GeeArDee/MScThesis/Thesis/main.tex

\special{pdf:minorversion 7}
\let\pdfcreationdate=\creationdate
\PassOptionsToPackage{dvipsnames}{xcolor}
\documentclass[12pt,letterpaper,twoside]{report}
%\usepackage{colorprofiles}
%\usepackage[a-2b,mathxmp]{pdfx}
\usepackage[todonotes={textsize=scriptsize}, final]{changes}
\usepackage[left=1in, right=1in, top=1in, bottom=1in]{geometry}
\usepackage{setspace}
\usepackage{layout}
\usepackage{parskip}
\usepackage{amsmath}
\usepackage{amssymb}
\usepackage[T1]{fontenc}
\usepackage{fontspec}
\setmainfont{XCharter}
\usepackage{unicode-math}
\setmathfont{XCharter-Math.otf}
\setsansfont{IBMPlexSans}[
    Extension = .otf,
    UprightFont = *-Regular,
    BoldFont = *-SemiBold,
    ItalicFont = *-Italic,
    BoldItalicFont = *-SemiBoldItalic,
    Scale = MatchLowercase
]
\setmonofont{IBMPlexMono}[Scale=MatchLowercase]
\usepackage{multicol}
\usepackage{multirow}
\usepackage{pdfpages}
\usepackage{pdflscape}
\usepackage{afterpage}
\usepackage{graphicx}
% \DeclareGraphicsExtensions{.png,.pdf}
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
    pdftitle={Design and Validation of a Laser Thermal Propulsion Thruster Powered by a Fiber Laser},
    pdfauthor={Gabriel Roland Dubé},
    pdflang={en-CA},
    pdfsubject={For ambitious space missions like rapid human transit to Mars, conventional propulsion methods fall short. Laser-Thermal Propulsion (LTP) utilizes lasers to heat propellant gas, generating thrust with potentially greater specific impulse than traditional rocket engines. Two lab-scale LTP thrusters were tested in this thesis, denoted Version 1 (V1) and Version 2 (V2). Version 1 permitted initial testing and visualization of the Laser-Sustained Plasma (LSP) wave propagation. As a prototype for an actual thruster, Version 2 was optimized for thrust measurements. The design process of the improved V2 thruster is also presented. These thrusters were powered by a 300 W Continuous Wave (CW), 3 kW Quasi-Continuous Wave (QCW) 1.07 μm fiber laser. Argon was used as the propellant at a pressure of 20 bar, selected for its ease of ionization. Using an automotive-type coil, spark initiation of QCW LSP was successfully implemented in V1 and V2. Seeding of the argon with nitrogen dioxide (NO₂) at partial pressures between 0.12 bar to 0.55 bar showed the gas absorbed more than double the laser energy compared to pure argon propellant. To increase laser flux to the plasma, an optical system of two lenses was designed. Different lenses were compared using ray tracing software (WinLens3D). A CW LSP was achieved in V2, lasting 85.1 ms. This represents a 1.7 times longer lifetime than the maximum QCW pulse length of 50.0 ms at this power. Average cold flow thrust of V2 was approximately 1 N. In order to interpret the experimental results, a zero-dimensional (0D) heat transfer model was written in Python, using Bremsstrahlung as the mechanism of radiation. Finally, paths to further improve the V2 thruster and thrust stand are presented to eventually enable accurate thrust measurements with CW operation.},
    pdfkeywords={Laser thermal propulsion, Directed energy, Advanced propulsion, Interplanetary spaceflight, Space technologies},
    pdfstartview=
}
\setdeletedmarkup{\textcolor{McGillRed}{\sout{#1}}}
% \setdeletedmarkup{\textcolor{McGillRed}{#1}}
\definechangesauthor[color=violet, name={Emmanuel Duplay}]{ED}
\definechangesauthor[color=cyan, name={Barry Zandbergen}]{BZ}
\definechangesauthor[color=McGillRed, name={Andrew Higgins}]{AH}

\setlength{\marginparwidth}{2cm}

% \input{titlesec.tex}
\addbibresource{ref.bib}

\title{Laser-Powered Rocket Engine: small-scale experimental investigation}
\author{Gabriel Dubé}
\date{0000-00-00}

\renewcommand{\headrulewidth}{0pt}
\renewcommand{\chaptermark}[1]{\markboth{\MakeUppercase{\thechapter.\ #1}}{}}
\renewcommand{\sectionmark}[1]{\markright{\MakeUppercase{\thesection.\ #1}}}

\renewcommand{\chapterautorefname}{Chapter}
\renewcommand{\sectionautorefname}{Section}

\renewcommand\labelitemi{---}

\newcommand{\shotsettings}[4]{\texttt{#1}: #2~ms, \textit{f}/#3, ND#4}

\newcommand{\dd}[2]{\frac{\mathrm{d}#1}{\mathrm{d}#2}}
\newcommand{\ddi}[2]{\mathrm{d}#1/\mathrm{d}#2}

\newcommand{\blankpage}{%
    \null
    \thispagestyle{empty}%
    \addtocounter{page}{-1}%
    \newpage}

% Track changes commands
% \newcommand{\change}[1]{\textcolor{McGillRed}{#1}}
% \newenvironment{changeblock}{\color{McGillRed}}{}
% \renewcommand{\change}[1]{#1}  % Comment out to suppress changes
% \renewenvironment{changeblock}{}{}  % Comment out to suppress changes

\fancypagestyle{fancy}{
    \fancyhf{}
    \fancyhfinit{\sffamily}
    \lhead{\leftmark}
    \rhead{\rightmark}
    % \lfoot{AE5050}
    % \rfoot{\thepage}
    \fancyfoot[LE,RO]{\thepage}
    %\fancyfoot[RE,LO]{AE5050}
}

\fancypagestyle{plain}{
    \fancyhf{}
    \fancyfoot[C]{\sffamily \thepage}
    
}

\pagestyle{fancy}

\SetWatermarkText{\sffamily \textbf{DRAFT}}
\SetWatermarkFontSize{2cm}
\SetWatermarkColor[gray]{0.85}
    
\input{lstStyle.tex}
\input{customenvs.tex}

\sisetup{detect-all}

\begin{document}
    \setlength{\parindent}{0pt}
    \setlength{\headheight}{27.4pt}
    % \includepdf{assets/cover.pdf}
    \input{title page.tex}

    \pagenumbering{roman}

    \hypersetup{linkcolor=black}
    \tableofcontents
    
    \listoffigures
    \addcontentsline{toc}{chapter}{List of Figures}
    
    \listoftables
    \addcontentsline{toc}{chapter}{List of Tables}
    \hypersetup{linkcolor=cyan}
    
    \input{chapters/0_1_nomenclature.tex}

    % ------------  UNCOMMENT THESE!!!! ------------------

    \newpage
    \input{chapters/0_2_abstract.tex}
    \input{chapters/0_3_abstract_fr.tex}
    \input{chapters/0_0_preface.tex}
    \afterpage{\blankpage}
    \newpage
    \pagenumbering{arabic}

    % \input{chapters/unnumberedchapter.tex}

    %UNCOMMENT THESE!!!!
    
    \input{chapters/1_intro.tex}
    \input{chapters/3_design.tex}
    \input{chapters/4_experiments.tex}
    \input{chapters/2_models.tex}
    \input{chapters/5_discussion.tex}
    \input{chapters/6_conclusion.tex}
    
    \clearpage
    \defbibnote{bibmark}{\markright{}}
    \printbibliography[
        heading=bibintoc,
        title={References},
        block=ragged,
        prenote=bibmark
        ]
    \newpage

    \appendix
    \newcommand{\footeronly}{\thispagestyle{fancy}\markboth{}{}}
    \chapter{YLR-300/3000-QCW-MM-AC Calibration Report}
        \label{chp:app_YLR}
        \includepdf[pages=-, pagecommand={\footeronly}]{assets/appendices/IPGLaser300-3000_calib.pdf}
    \chapter{P30 Collimator Calibration Report}
        \label{chp:app_Collimator}
        \includepdf[pages=-, pagecommand={\footeronly}]{assets/appendices/D30_Collimator_calib.pdf}
    \chapter{Omega PX119A-1KG5V Calibration}
        \label{chp:omega calibration}
        \includepdf[pages=-, pagecommand={\footeronly}]{assets/appendices/Omega Calibration.pdf}
    \chapter{V2 Test Section Parts Drawings}
        \label{chp:V2 Test Section Drawings}
        \includepdf[pages=-, pagecommand={\footeronly}]{assets/appendices/Test Apparatus.pdf}
    \chapter{V2 Second (Rear) Window Mount}
        \label{chp:V2 rear window mount}
        \includepdf[pages=-, pagecommand={\footeronly}]{assets/appendices/New V2 parts/Second Window Mount Final.pdf}
    \chapter{Untested V2 Parts Drawings}
        \includepdf[pages=-, pagecommand={\footeronly}]{assets/appendices/New V2 parts/sriel2_Extension cylinder real.pdf}\label{chp:Extension cylinder}
        \includepdf[pages=-, pagecommand={\footeronly}]{assets/appendices/New V2 parts/Inner Cylinder.pdf}\label{chp:remachined inner cylinder}
        \includepdf[pages=-, pagecommand={\footeronly}]{assets/appendices/New V2 parts/Exchangeable Nozzle.pdf}\label{chp:New nozzle}
        \includepdf[pages=-, pagecommand={\footeronly}]{assets/appendices/New V2 parts/sriel2_Exchangeable Nozzle Plate_inches.pdf}\label{chp:Exchangeable nozzle plate}
        \includepdf[pages=-, pagecommand={\footeronly}]{assets/appendices/New V2 parts/Higher Width Plate.pdf}\label{chp:thicker plate}

    % List of appendicies that I want:
        % [x] Laser and colimator calibration
        % [x] Bubble meter calibration Thariq's report
        % [x] Drawings for V2 from Capstone team
        % [x] V2 rear window mount
        % Drawings of untested parts
            % [x] Modified inner cylinder
            % [x] Spacer for static tests
            % [x] Flat plate with hole for bubble tests
            % [x] Flat plate for changeable graphite nozzles
            % [x] Graphite nozzles
    
\end{document}
