GeeArDee/MScThesis/Thesis/title page.tex

\begin{titlepage}
  \thispagestyle{empty}
  \sffamily
  \begin{center}
     \\
    \vspace*{2cm}
    
    \huge
    \textbf{Design and Validation of a Laser~Thermal~Propulsion~Thruster Powered~by~a~Fiber~Laser}
    
    \large
    % \textit{Small-scale experimental investigation}     

    \vspace{1.5cm}    
    \textbf{Gabriel Roland Dubé}\\

    \vspace{0.5cm}
    Department of Mechanical Engineering\\
    McGill University, Montreal\\

    \vspace{1.5cm}
    July 2025\\
    \vspace{1.5cm}
    
    A thesis submitted to McGill University \\
    in partial fulfillment of the requirements of the degree of\\
    \textbf{Master of Science}\\
    
    %\vskip 10mm
    \vfill

    {\color{red}\hrule}

    \copyright Gabriel Roland Dubé, 2025
            
  \end{center}
\end{titlepage}
