GeeArDee/MScThesis/Emmanuel's Thesis/assets/cover.pdf

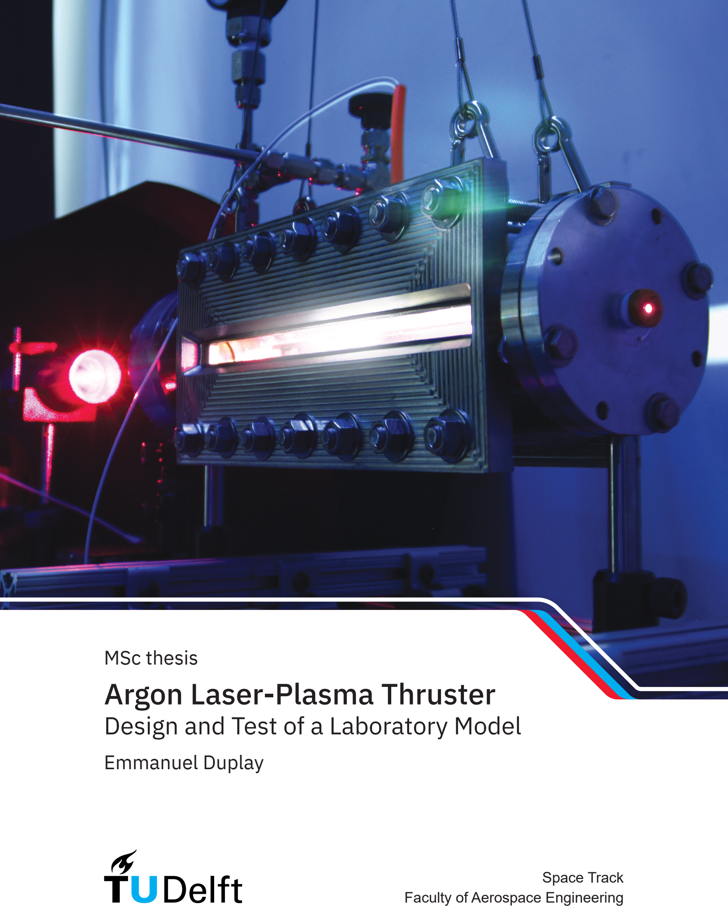
[picture p34: page 1]

## MSc thesis

# Argon Laser-Plasma Thruster

# Design and Test of a Laboratory Model

## Emmanuel Duplay

Space Track
Faculty of Aerospace Engineering
