GeeArDee/MScThesis/Thesis/assets/2 models/Mechanism of LSP growth.pdf

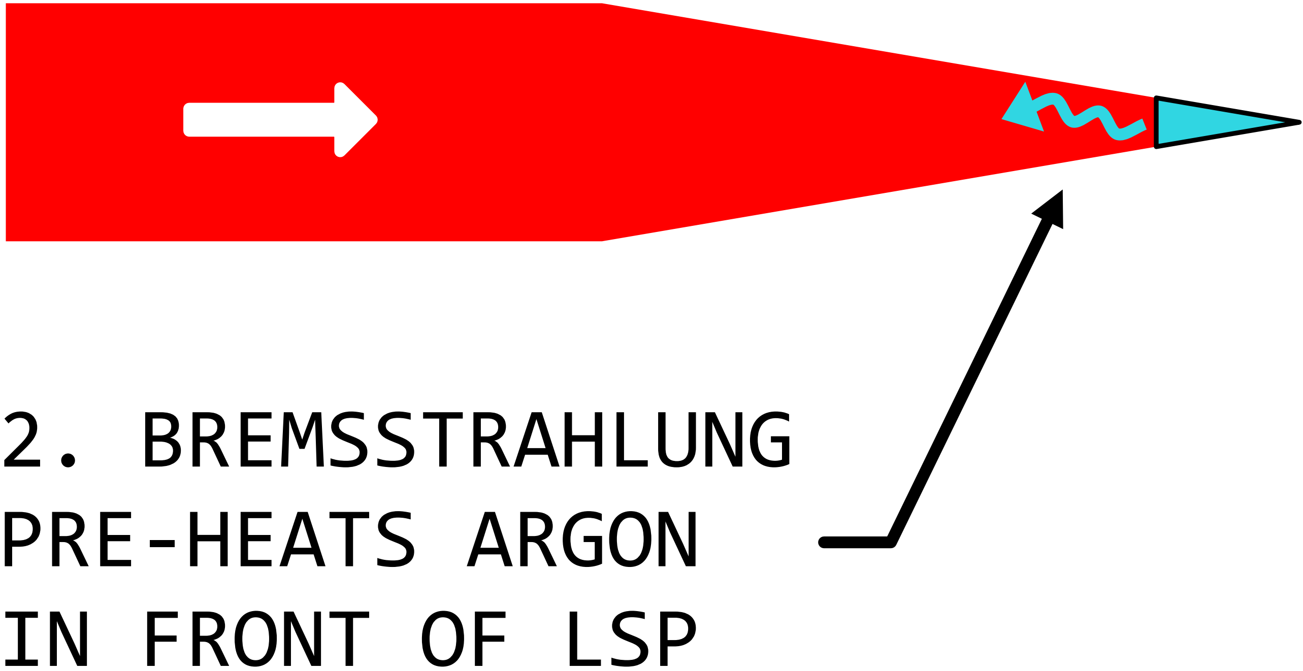
[picture p35: figure]
2. BREMSSTRAHLUNG PRE-HEATS ARGON IN FRONT OF LSP

3. LSP GROWTH
UPSTREAM
1. LASER ENERGY IN
