GeeArDee/MScThesis/Thesis/assets/2 models/Modeling figure.pdf

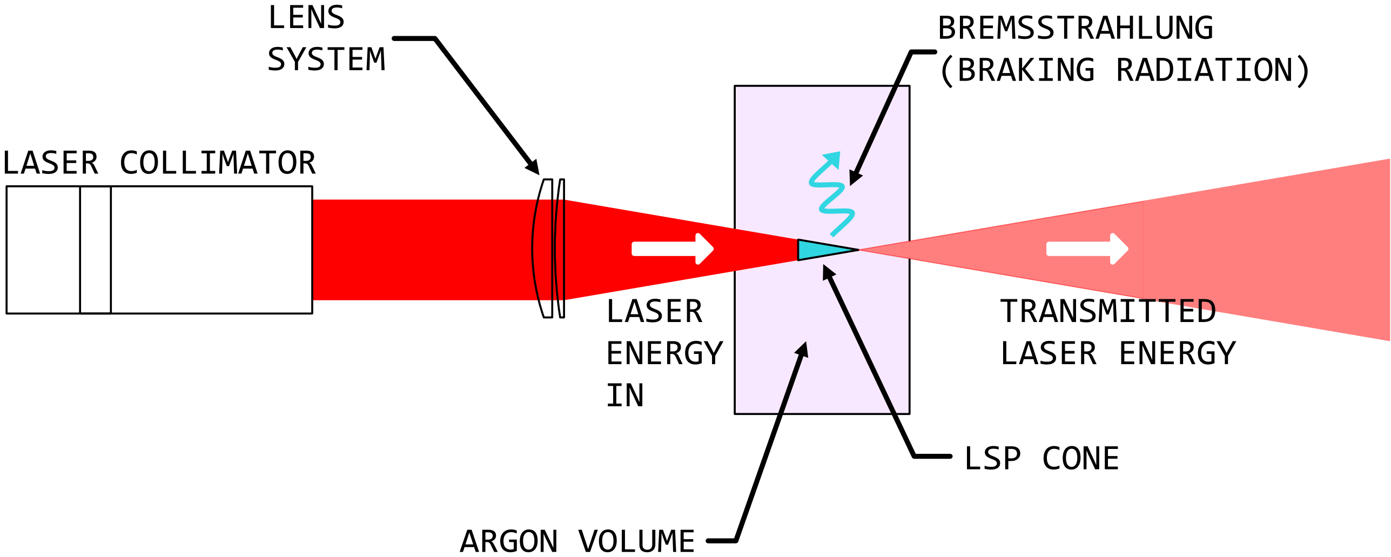
[picture p36: figure]
LASER COLLIMATOR; LENS SYSTEM; LSP CONE; ARGON VOLUME; TRANSMITTED LASER ENERGY; LASER ENERGY IN; BREMSSTRAHLUNG (BRAKING RADIATION)
