GeeArDee/MScThesis/Thesis/assets/3 design/100 lens spot size.pdf

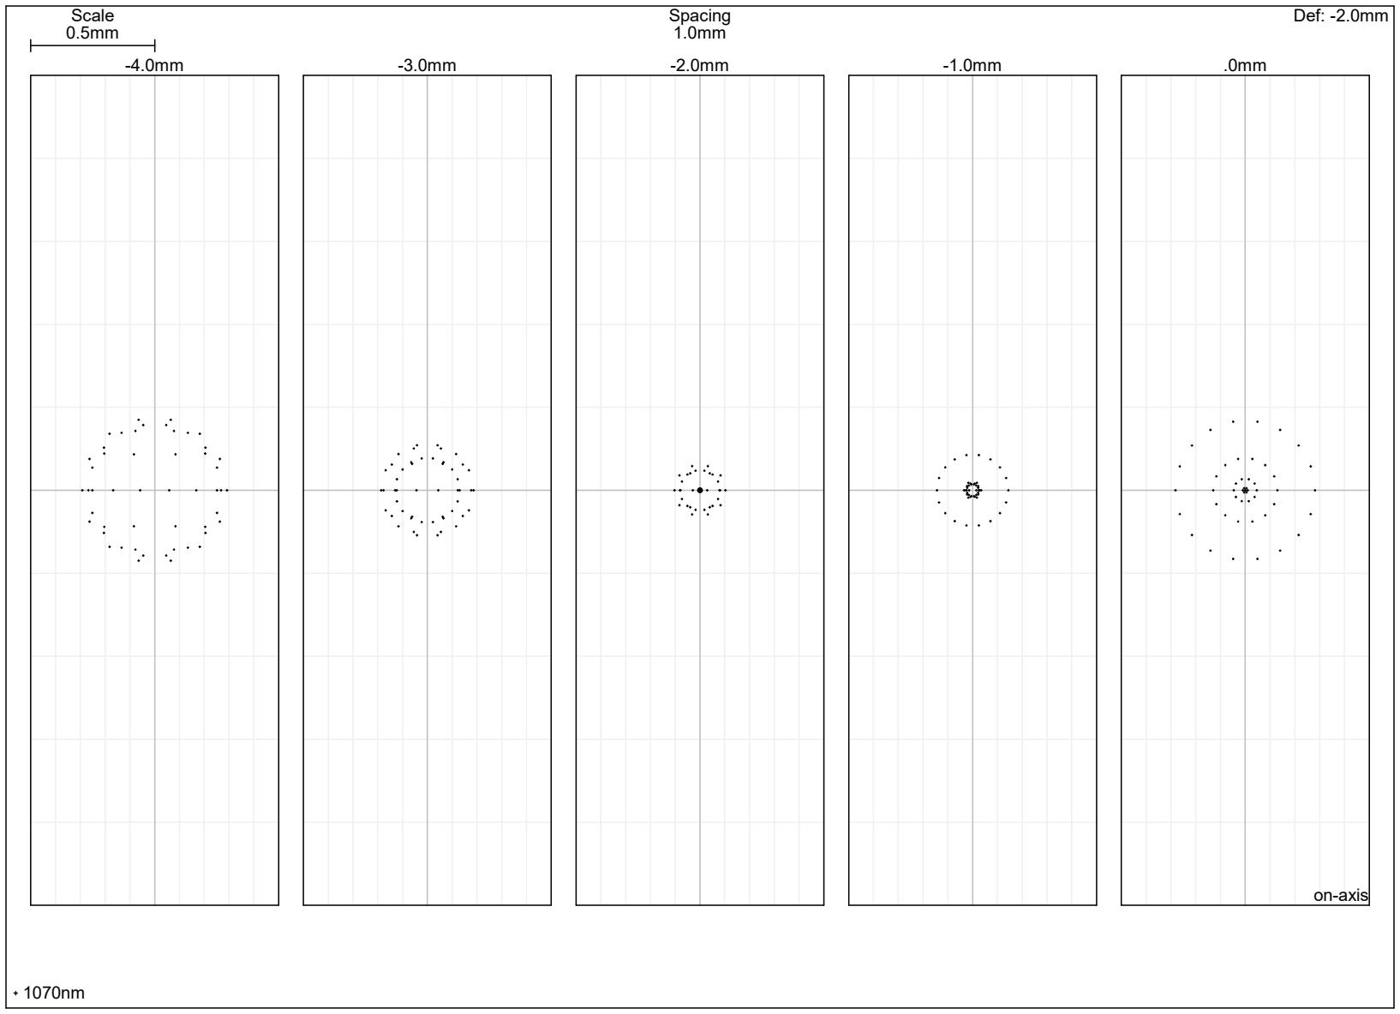
[picture p39: figure]
Scale 0.5mm; Spacing 1.0mm; Def: -2.0mm; on-axis
