GeeArDee/MScThesis/Thesis/assets/3 design/500 and 150 lenses spot size.pdf

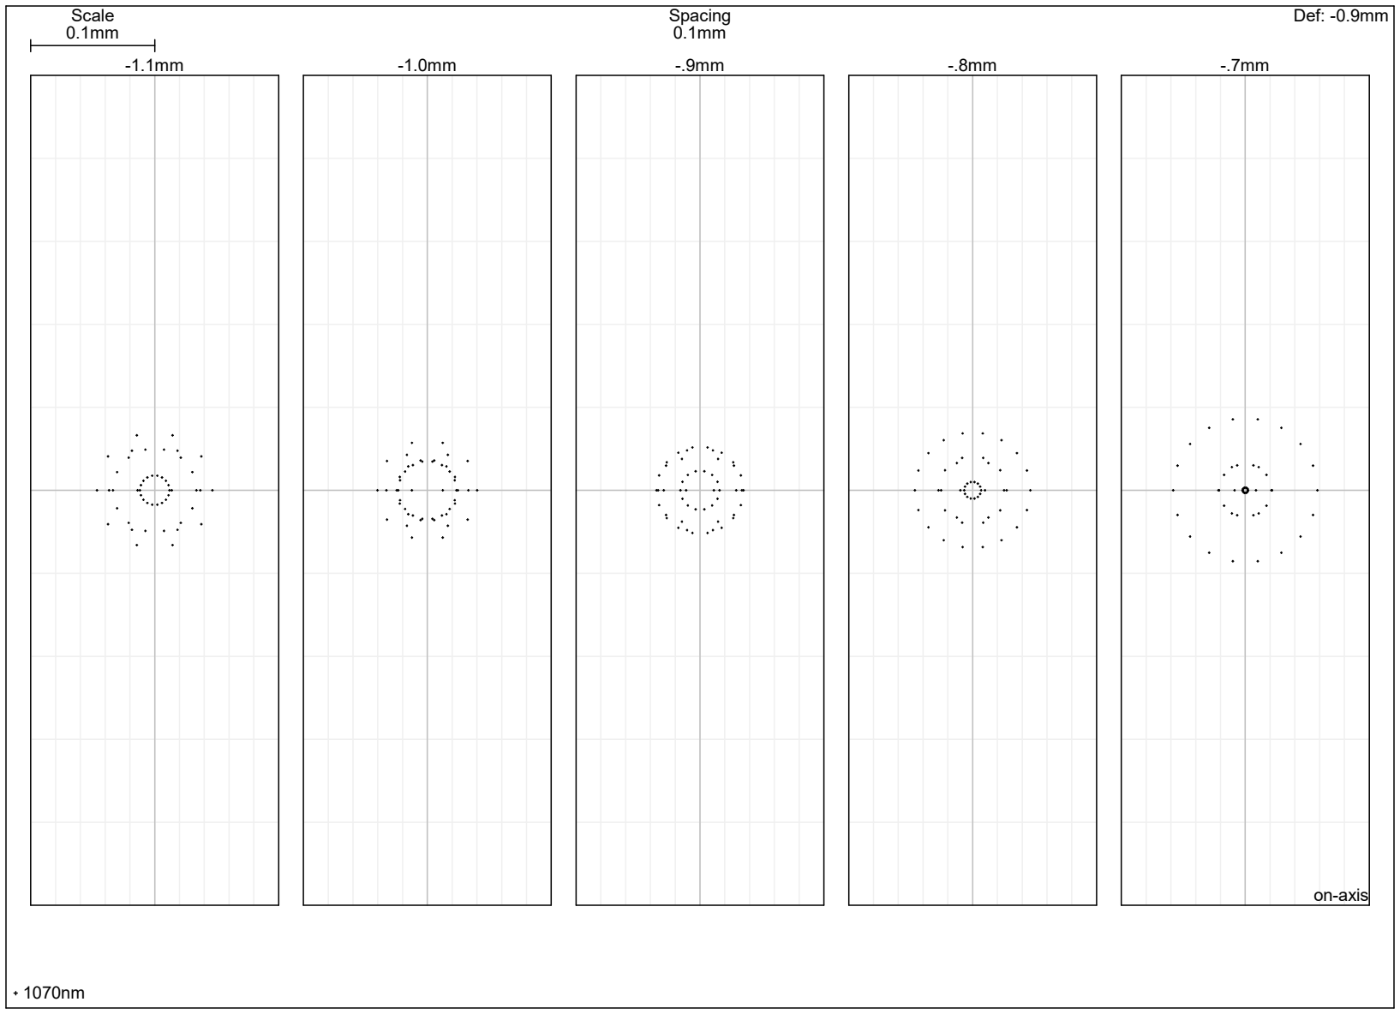
[picture p40: figure]
Scale 0.1mm; Spacing 0.1mm; Def: -0.9mm; on-axis
