GeeArDee/MScThesis/Thesis/assets/2 background/Kamei apparatus.png

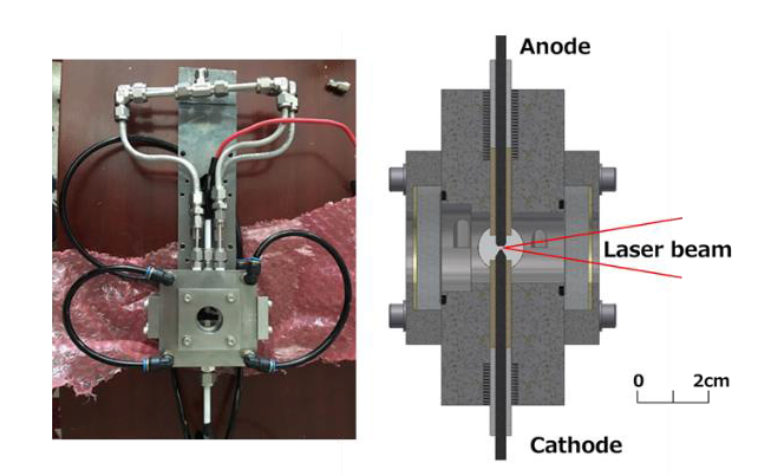
Thesis/assets/2 background/Kamei apparatus.png
