GeeArDee/MScThesis/Thesis/assets/2 background/Shoji_assy.png

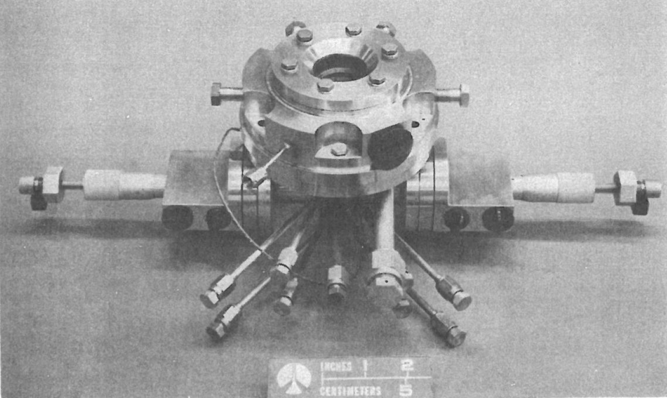
Thesis/assets/2 background/Shoji_assy.png
