GeeArDee/MScThesis/Thesis/assets/2 models/Brems vs exp graph.png

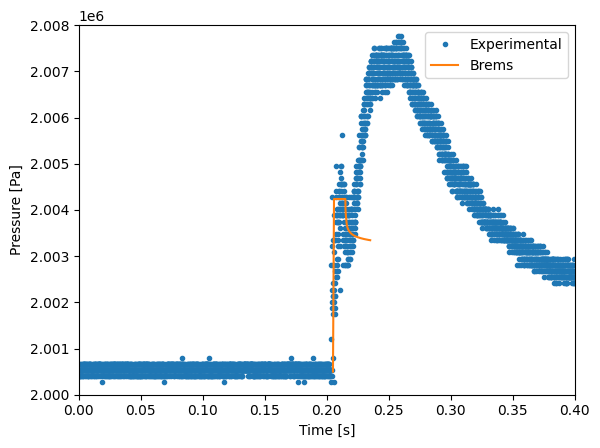
Thesis/assets/2 models/Brems vs exp graph.png
