GeeArDee/MScThesis/Thesis/assets/3 design/V1 IRL.jpg

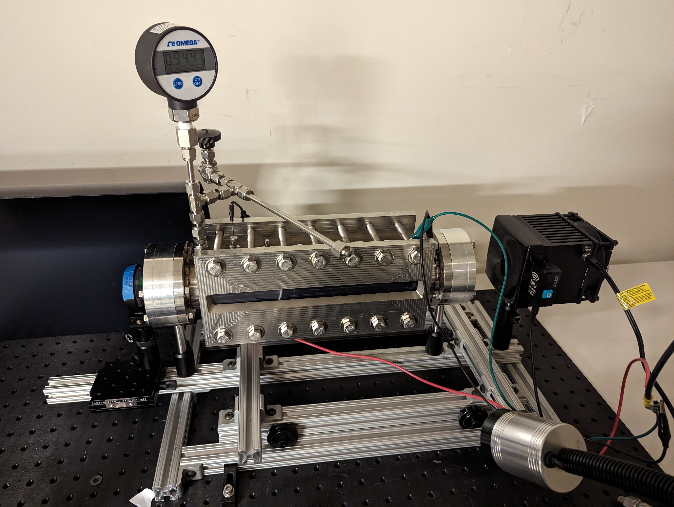
Thesis/assets/3 design/V1 IRL.jpg
