GeeArDee/MScThesis/Thesis/assets/5 discussion/hysterisis.png

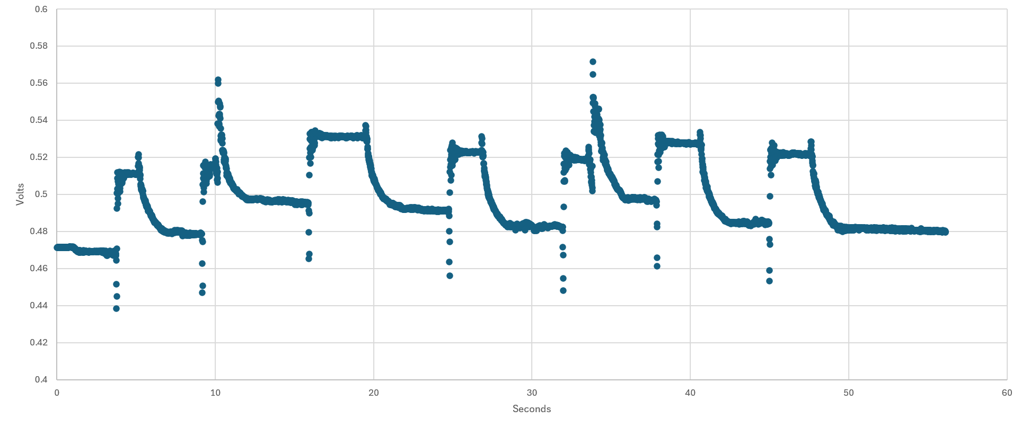
Thesis/assets/5 discussion/hysterisis.png
