GeeArDee/MScThesis/Thesis/chapters/0_1_nomenclature.tex

\chapter*{Nomenclature}
\setlength{\columnsep}{1cm}
\newenvironment{nomtable}
    {
        \centering
        \tabularx{\columnwidth}{r>{\raggedright\arraybackslash}X}
    }
    {
        \endtabularx
    }
\newenvironment{nomlist}
    {
        \begin{itemize}[leftmargin=1.5cm]
            \raggedright
            \setlength{\parsep}{0pt}
            \setlength{\itemsep}{-4pt}
    }
    {
        \end{itemize}
    }
\addcontentsline{toc}{chapter}{Nomenclature}
\markboth{\MakeUppercase{Nomenclature}}{}

% \newcommand{\evalc}{\qty{2.99792e8}{m.s^{-1}}}
% \newcommand{\evale}{\qty{1.60218e-19}{C}}
% \newcommand{\evalg}{\qty{9.80665}{m.s^{-2}}}
% \newcommand{\evalhbar}{\qty{1.05457e-34}{J.s}}
% \newcommand{\evalkB}{\qty{1.38065e-23}{J.K^{-1}}}
% \newcommand{\evalme}{\qty{9.10938e-31}{kg}}
% \newcommand{\evalNA}{\qty{6.02214e+23}{mol^{-1}}}
% \newcommand{\evalRu}{\qty{8.31446}{J.K^{-1}.mol^{-1}}}
% \newcommand{\evalepsilon}{\qty{8.85419e-12}{F.m^{-1}}}

% \section*{Physical Constants}
%     {\centering\sisetup{table-alignment-mode=format, table-number-alignment=right}
%         \begin{tabularx}{\textwidth}{@{}lXS[table-format = 1.5e4]@{ }lr@{}}
%             \toprule
%             Symbol      & Name    & {Value}     & Unit  & Ref. \\
%             \midrule
%             $c$ &              Speed of light in a vacuum   & 2.99792e8     & \unit{m.s^{-1}} & \cite{tiesingaFundamentalPhysicalConstants2019} \\
%             $e$ &              Elementary charge            & 1.60218e-19   & \unit{C} & \cite{tiesingaFundamentalPhysicalConstants2019} \\
%             $g_0$ &            Standard gravity             & 9.80665       & \unit{m.s^{-2}} & \cite{tiesingaFundamentalPhysicalConstants2019} \\
%             $\hbar$ &          Reduced Planck constant      & 1.05457e-34   & \unit{J.s} & \cite{tiesingaFundamentalPhysicalConstants2019} \\
%             $k_\mathrm{B}$ &   Boltzmann constant           & 1.38065e-23   & \unit{J.K^{-1}} & \cite{tiesingaFundamentalPhysicalConstants2019} \\
%             $m_\mathrm{e}$ &    Electron mass               & 9.10938e-31   & \unit{kg} & \cite{tiesingaFundamentalPhysicalConstants2019} \\
%             $N_\mathrm{A}$ &   Avogadro's number            & 6.02214e+23   & \unit{mol^{-1}} & \cite{tiesingaFundamentalPhysicalConstants2019} \\
%             $R_\mathrm{u}$ &   Universal gas constant       & 8.31446       & \unit{J.K^{-1}.mol^{-1}} & \cite{tiesingaFundamentalPhysicalConstants2019} \\
%             $\epsilon_0$ &     Permittivity of free space   & 8.85419e-12   & \unit{F.m^{-1}} & \cite{tiesingaFundamentalPhysicalConstants2019} \\
%             \bottomrule
%         \end{tabularx}
%     }
%     \bigskip

% \begin{multicols}{2}
    % \setlength{\columnseprule}{1pt}
    \section*{Abbreviations}

    \begin{nomlist}
        \item[0D]               Zero-dimensional
        \item[BPP]              Beam Parameter Product
        \item[CW]               Continuous Wave
        \item[DAQ]              Data Acquisition
        \item[FOV]              Field Of View
        \item[IR]               Infrared  
        \item[LSP]              Laser-Sustained Plasma
        \item[LTP]              Laser-Thermal Propulsion
        \item[MAOP]             Maximum Allowable Operating Pressure
        \item[NPT]              National Pipe Thread
        \item[QCW]              Quasi-Continuous Wave
        \item[STP]              Standard Temperature and Pressure 
        \item[UV]               Ultraviolet 
        \item[V1]               Version 1
        \item[V2]               Version 2 
    \end{nomlist}

    % \begin{nomlist}
    %     \item[$c$]              Speed of light in a vacuum (\qty{2.99792e8}{m.s^{-1}}) 
    %     \item[$e$]              Elementary charge (\qty{1.60218e-19}{C})
    %     \item[$g_0$]            Standard gravity (\qty{9.80665}{m.s^{-2}}) 
    %     \item[$\hbar$]          Reduced Planck constant (\qty{1.05457e-34}{J.s})
    %     \item[$k_\mathrm{B}$]   Boltzmann constant (\qty{1.38065e-23}{J.K^{-1}})
    %     \item[$N_\mathrm{A}$]   Avogadro's number (\qty{6.02214e+23}{mol^{-1}})
    %     \item[$R_\mathrm{u}$]   Universal gas constant (\qty{8.31446}{J.K^{-1}.mol^{-1}})
    %     \item[$\epsilon_0$]     Permittivity of free space (\qty{8.85419e-12}{F.m^{-1}})
    % \end{nomlist}

    % \section*{Latin symbols}
    % \begin{nomlist}
    %     \item[$A$]              Einstein coefficient, \\or area%[\unit{s^{-1}}]
    %     \item[$\mathsf{A}$]     Empirically derived parameter A for Paschen's law 
    %     \item[$\mathsf{B}$]     Empirically derived parameter B for Paschen's law 
    %     \item[$c_p$]            Specific heat of enthalpy
    %     \item[$c_V$]            Specific heat of internal energy
    %     \item[$D$]              Diameter
    %     \item[$d$]              Distance
    %     \item[$E$]              Energy
    %     \item[$g$]              Degeneracy of atomic energy level
    %     \item[$h$]              Enthalpy
    %     \item[$I$]              Local laser flux %[\unit{W.m^{-2}}]
    %     \item[$I_\text{sp}$]    Specific impulse %[\unit{s}]
    %     \item[$K_{\dot{m}}$]    Choked-mass-flow parameter %(Argon: \qty{0.0504}{s.K^{1/2}.m^{-1}}) 
    %     \item[$k$]              Thermal conductivity 
    %     \item[$L$]              Leak rate
    %     \item[$\ell$]           Relative power loss
    %     \item[$m$]              Mass
    %     \item[$\mathcal{M}$]    Molar mass
    %     \item[$N$]              Number of moles 
    %     \item[$N_\mathrm{f}$]   F-number
    %     \item[$n$]              Number density 
    %     \item[$n_\mathrm{sp}$]  Laser setpoint 
    %     \item[$P$]              Power 
    %     \item[$p$]              Pressure
    %     \item[$Q$]              Heat
    %     \item[$q$]              Charge
    %     \item[$R_\mathrm{g}$]   Specific gas constant
    %     \item[$r$]              Radius 
    %     \item[$T$]              Temperature
    %     \item[$T_E$]              Temperature in energy units
    %     \item[$t$]              Time
    %     \item[$V$]              Volume
    %     \item[$V_\mathrm{B}$]   Breakdown Voltage
    %     \item[$v$]              Velocity
    %     \item[$Z$]              Ion charge state
    %     \item[$\mathcal{Z}$]    Partition function
    % \end{nomlist}

    % \section*{Greek symbols}
    % \begin{nomlist}
    %     \item[$\alpha$]         Radiation absorption coefficient %[\unit{m^{-1}}]
    %     \item[$\gamma$]         Specific heat ratio
    %     \item[$\gamma_\mathrm{se}$]         Secondary-electron-emission coefficient
    %     \item[$\epsilon$]       Integrated line emission intensity 
    %     \item[$\eta$]           Efficiency 
    %     \item[$\Lambda_\mathrm{th}$]        Thermal DeBroglie wavelength
    %     \item[$\lambda$]        Wavelength
    %     \item[$\nu$]            Frequency
    %     \item[$\rho$]           Density
    %     \item[$\rho_\mathrm{min}$]  Electron--ion collision minimum impact parameter
    %     \item[$\sigma$]         Normal stress
    % \end{nomlist}

    % \section*{Subscripts}
    % \begin{nomlist}
    %     \item[a]                Ambient
    %     \item[c]                Thrust chamber
    %     \item[e]                Electron
    %     \item[ex]               Exhaust
    %     \item[eq]               Equivalent (exhaust velocity)
    %     \item[f]                Focusing length
    %     \item[$i$]              Lower atomic energy level 
    %     \item[in]               Input
    %     \item[ion]              Ionization
    %     \item[$k$]              Upper atomic energy level 
    %     \item[l]                Lens
    %     \item[m]                Measured
    %     \item[r]                Laser receiver, \\or reference
    %     \item[T]                Thrust
    %     \item[t]                Throat
    %     \item[w]                Window
    % \end{nomlist}

    % \section*{Superscripts}
    % \begin{nomlist}
    %     \item[$n$]  time index
    % \end{nomlist}

%\end{multicols}
