GeeArDee/MScThesis/(list of files, cad)

Other CAD files:
LWM-G_LASERCUT_PROC.dwg
