GeeArDee/MScThesis/Emmanuel's Thesis/assets/3 design/setup.pdf

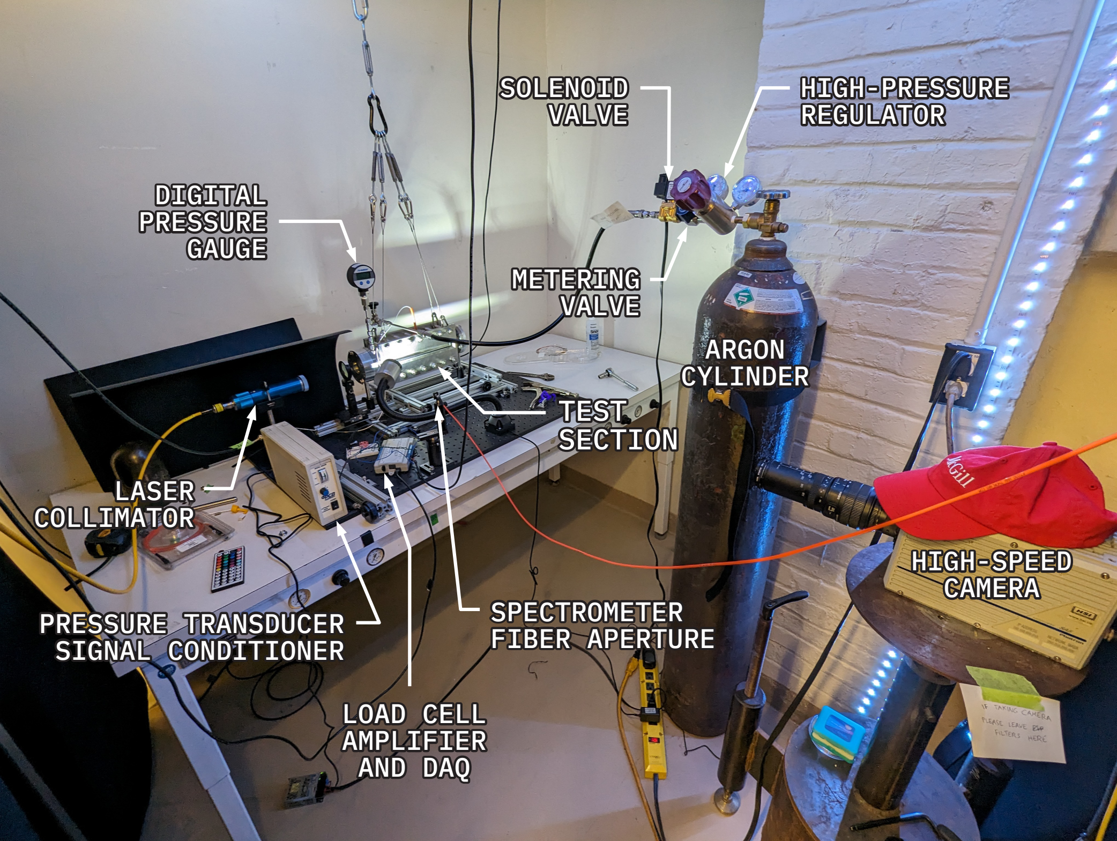
[picture p97: page 1]

HIGH-SPEED
CAMERA

ARGON
CYLINDER

HIGH-PRESSURE
REGULATOR

SOLENOID
VALVE

METERING
VALVE

DIGITAL
PRESSURE
GAUGE

LASER
COLLIMATOR

PRESSURE TRANSDUCER
SIGNAL CONDITIONER

LOAD CELL
AMPLIFIER
AND DAQ

SPECTROMETER
FIBER APERTURE

TEST
SECTION
