GeeArDee/MScThesis/Thesis/assets/4 experiments/CW LSP frames webcam/igntionFrames.tex

\begin{figure}[!ht]
    \centering
    \begin{subfigure}[t]{0.45\textwidth}
        \centering
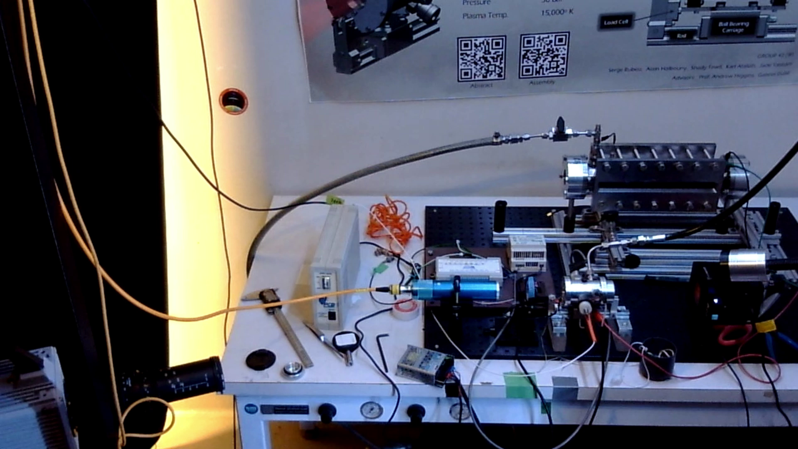
[picture p117: Thesis/assets/4 experiments/CW LSP frames webcam/Before Laser.png]
        
        \caption{Laser on - \qty{1}{s}}
    \end{subfigure}
    \hfill
    \begin{subfigure}[t]{0.45\textwidth}
        \centering
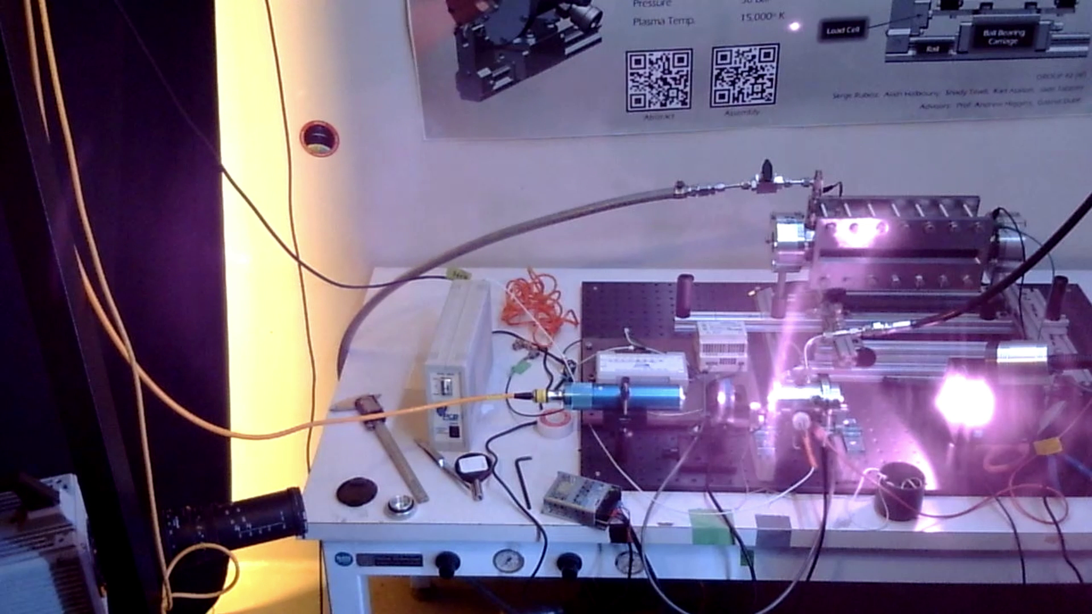
[picture p118: Thesis/assets/4 experiments/CW LSP frames webcam/Laser on.png]
        
        \caption{Laser on + \qty{0}{s}}
    \end{subfigure}
    \begin{subfigure}[t]{0.45\textwidth}
        \centering
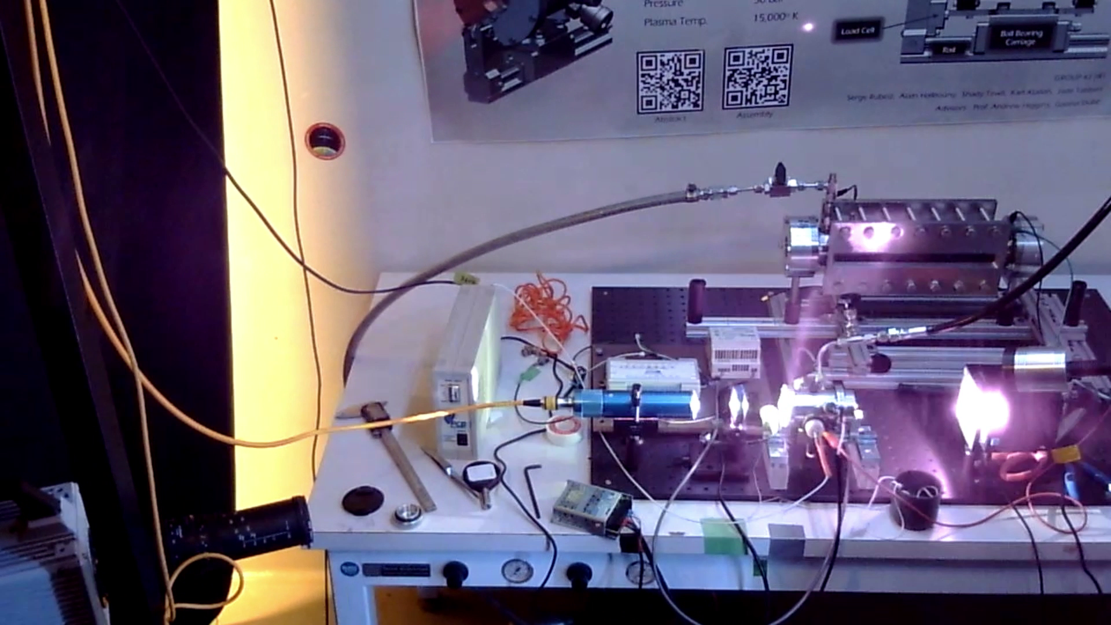
[picture p119: Thesis/assets/4 experiments/CW LSP frames webcam/LSP initiation.png]
        
        \caption{Laser on + \qty{0.5}{s}: LSP spark initiation}
        \label{fig:CW_V2_webcam_frames_LSP}
    \end{subfigure}
    \hfill
    \begin{subfigure}[t]{0.45\textwidth}
        \centering
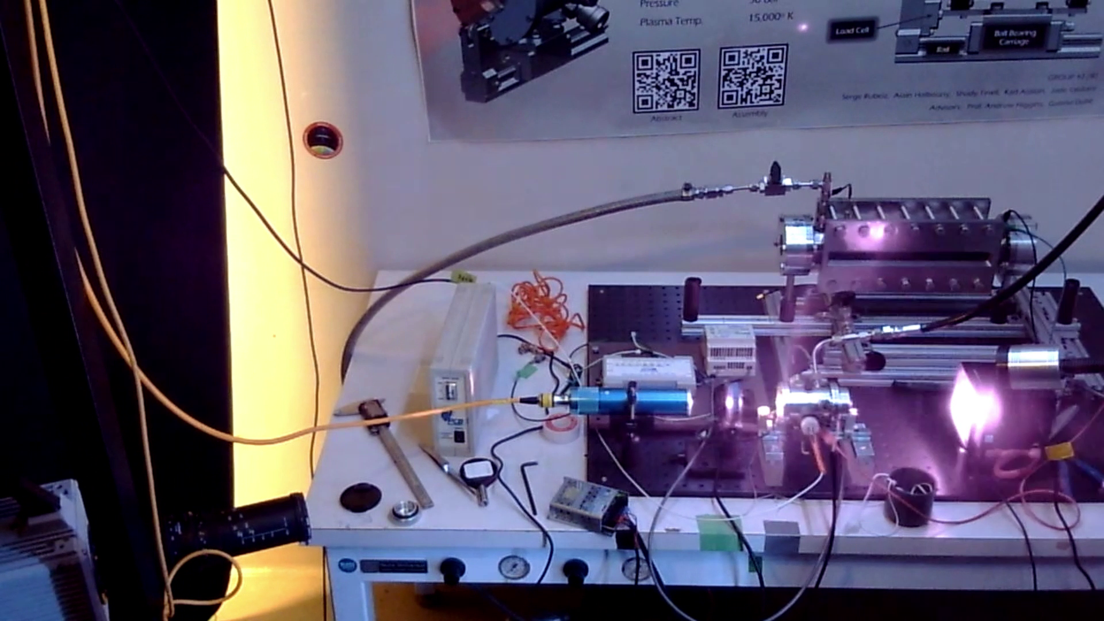
[picture p120: Thesis/assets/4 experiments/CW LSP frames webcam/After LSP.png]
        
        \caption{Laser on + \qty{1}{s}}
    \end{subfigure}
    \caption{First CW LSP captured by the webcam: \qty{342}{W}, \qty{20.00}{bar}. LSP385\_V2\_CW1.}
    \label{fig:CW_V2_webcam_frames}
\end{figure}
