GeeArDee/MScThesis/Thesis/assets/4 experiments/V1 Spark Ignition Frames/igntionFrames.tex

\begin{figure}[!ht]
    \centering
    \begin{subfigure}[t]{0.3\textwidth}
        \centering
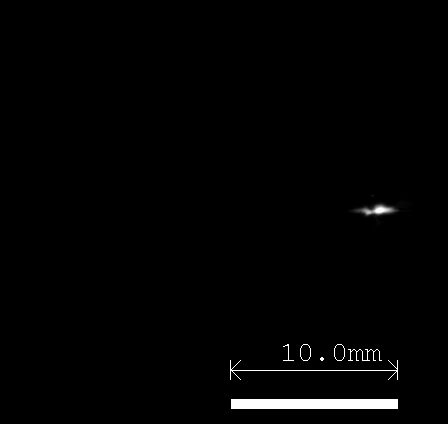
[picture p121: Thesis/assets/4 experiments/V1 Spark Ignition Frames/LSP142_SPRK15_Fr32.png]
        
        \caption{\qty{3.2}{ms}}
        %\label{fig:V1_ignition_frames_16}
    \end{subfigure}
    \hfill
    \begin{subfigure}[t]{0.3\textwidth}
        \centering
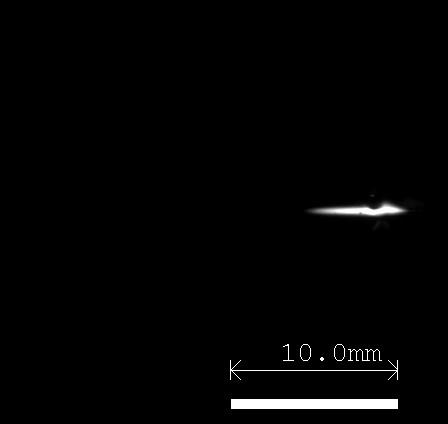
[picture p122: Thesis/assets/4 experiments/V1 Spark Ignition Frames/LSP142_SPRK15_Fr33.png]
        
        \caption{\qty{3.3}{ms}}
        %\label{fig:ignition_frames_17}
    \end{subfigure}
    \hfill
    \begin{subfigure}[t]{0.3\textwidth}
        \centering
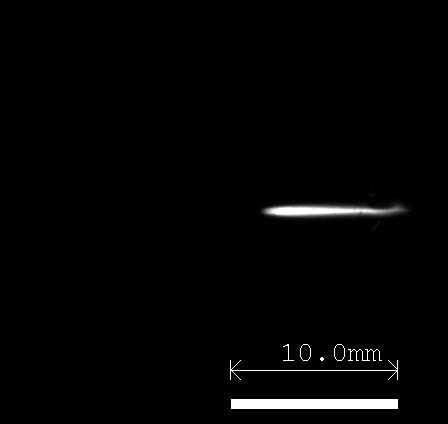
[picture p123: Thesis/assets/4 experiments/V1 Spark Ignition Frames/LSP142_SPRK15_Fr35.png]
        
        \caption{\qty{3.5}{ms}}
        %\label{fig:ignition_frames_18}
    \end{subfigure}
    \begin{subfigure}[t]{0.3\textwidth}
        \centering
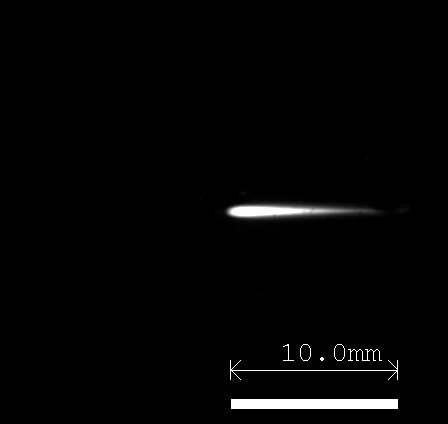
[picture p124: Thesis/assets/4 experiments/V1 Spark Ignition Frames/LSP142_SPRK15_Fr38.png]
        
        \caption{\qty{3.8}{ms}}
        %\label{fig:ignition_frames_19}
    \end{subfigure}
    \hfill
    \begin{subfigure}[t]{0.3\textwidth}
        \centering
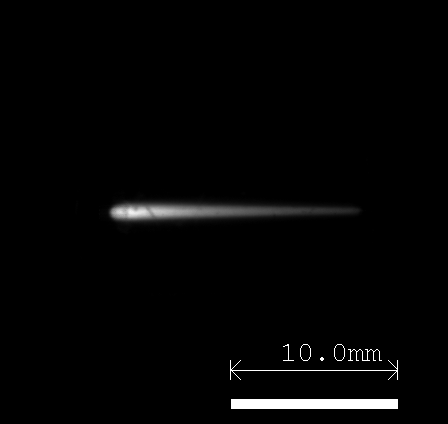
[picture p125: Thesis/assets/4 experiments/V1 Spark Ignition Frames/LSP142_SPRK15_Fr69.png]
        
        \caption{\qty{6.9}{ms}}
        %\label{fig:ignition_frames_20}
    \end{subfigure}
    \hfill
    \begin{subfigure}[t]{0.3\textwidth}
        \centering
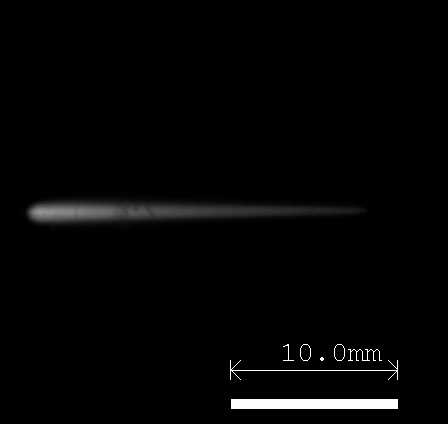
[picture p126: Thesis/assets/4 experiments/V1 Spark Ignition Frames/LSP142_SPRK15_Fr130.png]
        
        \caption{\qty{13.0}{ms}}
        %\label{fig:ignition_frames_21}
    \end{subfigure}
    \caption{QCW LSP spark initiation in V1: \qty{3079}{W}, \qty{20}{bar}. LSP142\_SPRK15.}
    \label{fig:V1_spark_initiation_frames}
\end{figure}
