GeeArDee/MScThesis/Thesis/assets/4 experiments/timings.pdf

trig_main

trig_spark

trig_laser

laser

spark

0.0 | 5.0 | 10.0 | 15.0 | 20.0 | 25.0
Time [ms]

3.0

3.1

1.0

12.3

3.1 5.9
