GeeArDee/MScThesis/Thesis/assets/4 experiments/10p 50ms Statistics.png

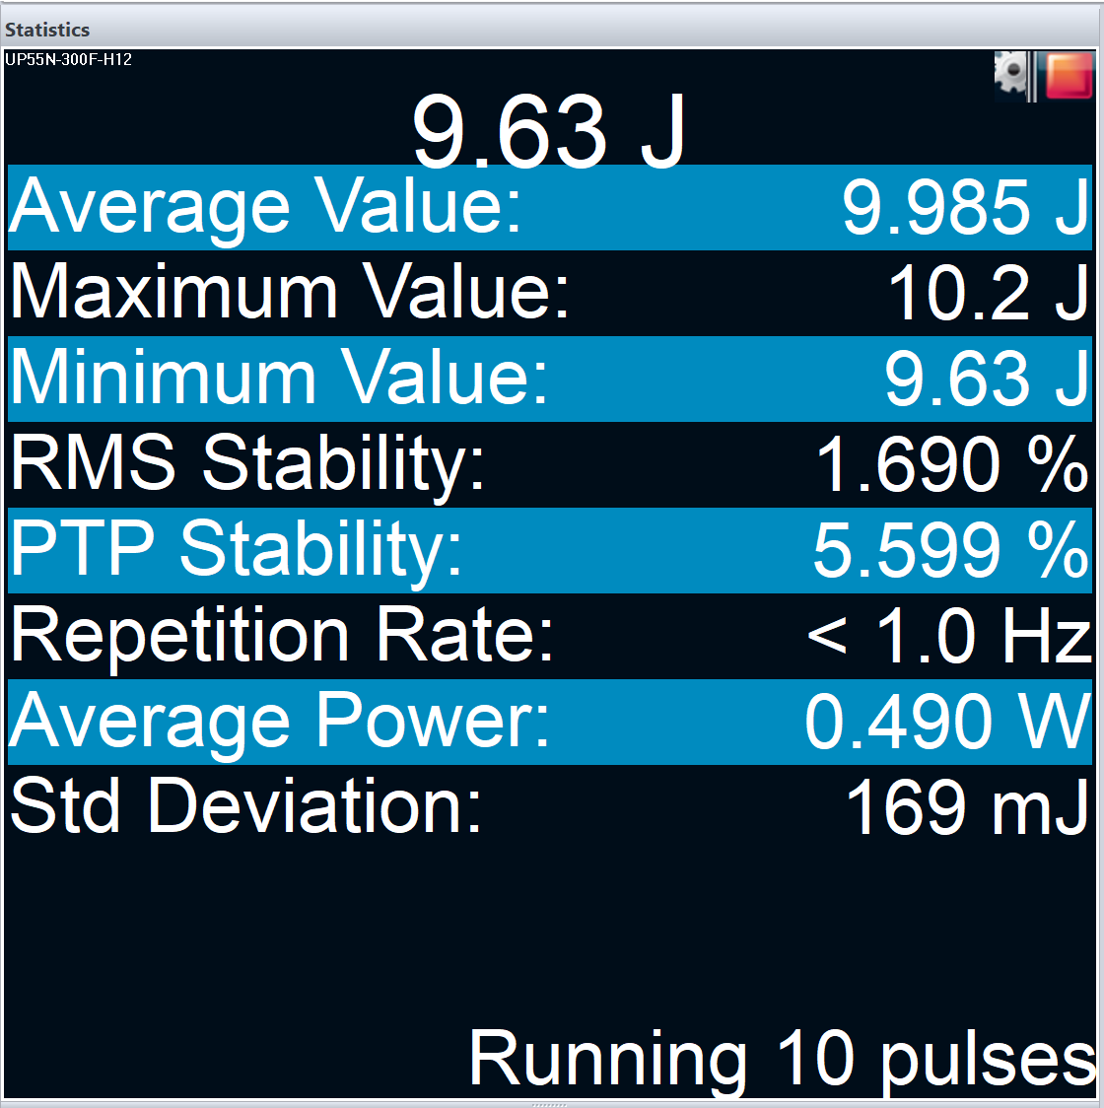
Thesis/assets/4 experiments/10p 50ms Statistics.png
