GeeArDee/MScThesis/Thesis/assets/4 experiments/CW pressure rise.png

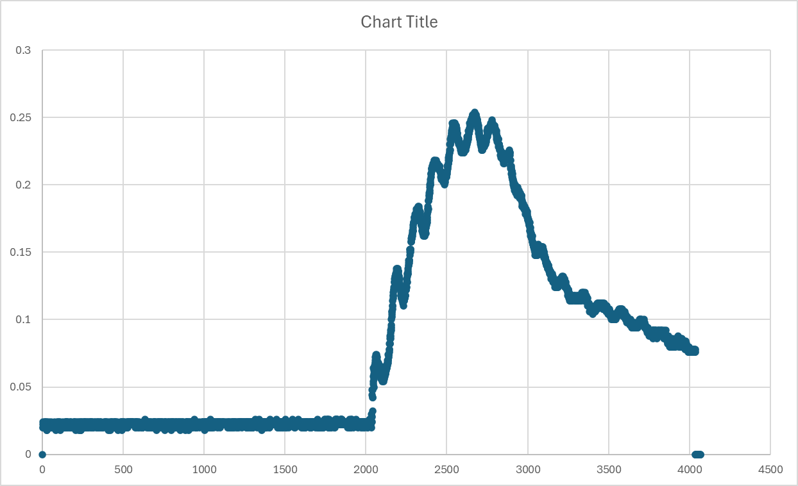
Thesis/assets/4 experiments/CW pressure rise.png
