GeeArDee/MScThesis/Thesis/assets/4 experiments/Shattered 500 mm lens.jpg

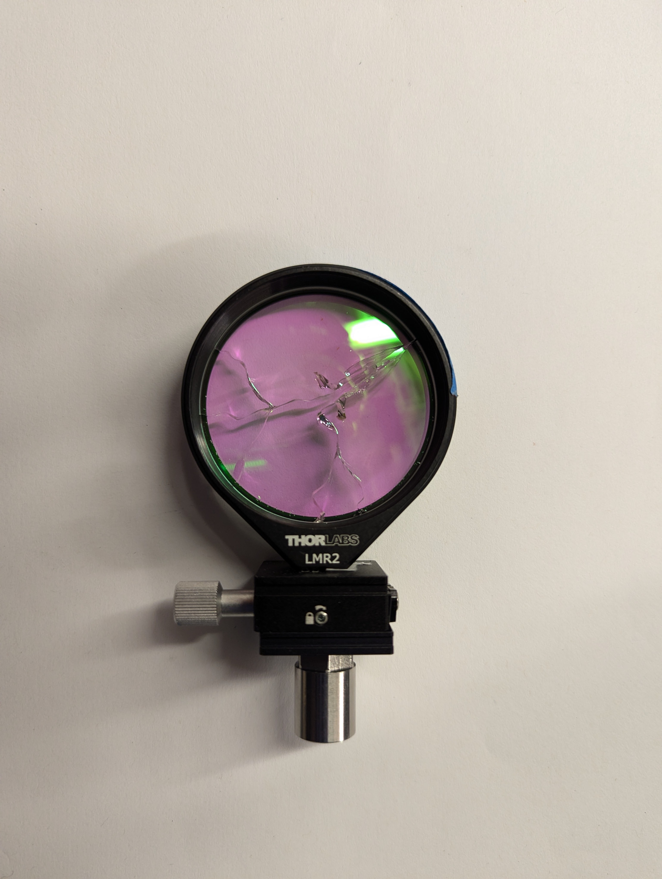
Thesis/assets/4 experiments/Shattered 500 mm lens.jpg
