GeeArDee/MScThesis/Thesis/assets/4 experiments/window damage.jpg

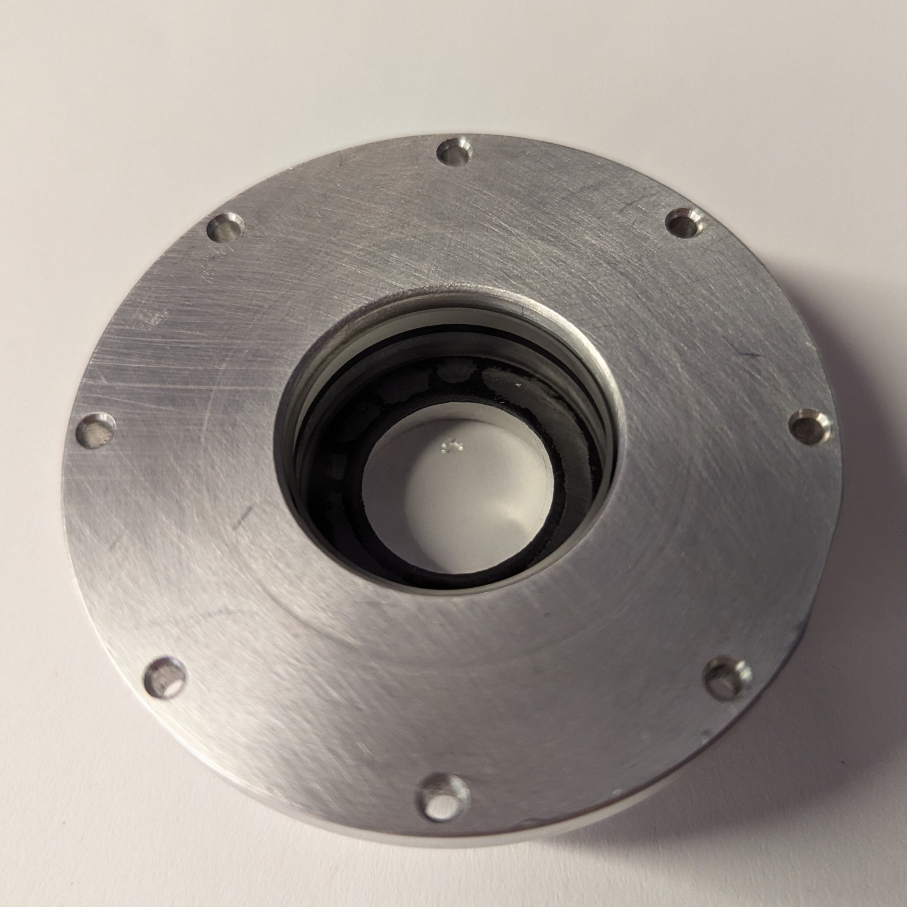
Thesis/assets/4 experiments/window damage.jpg
