GeeArDee/MScThesis/Thesis/assets/3 design/Double choked LTP thruster.pdf

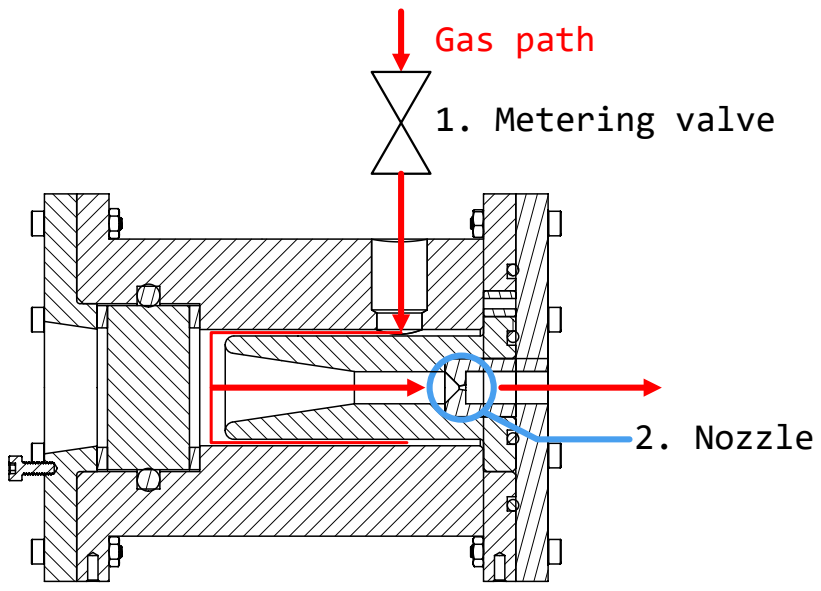
[picture p157: page 1]
1. Metering valve; Gas path; 2. Nozzle
