GeeArDee/MScThesis/Thesis/assets/4 experiments/NO2_shots_analysis.pdf

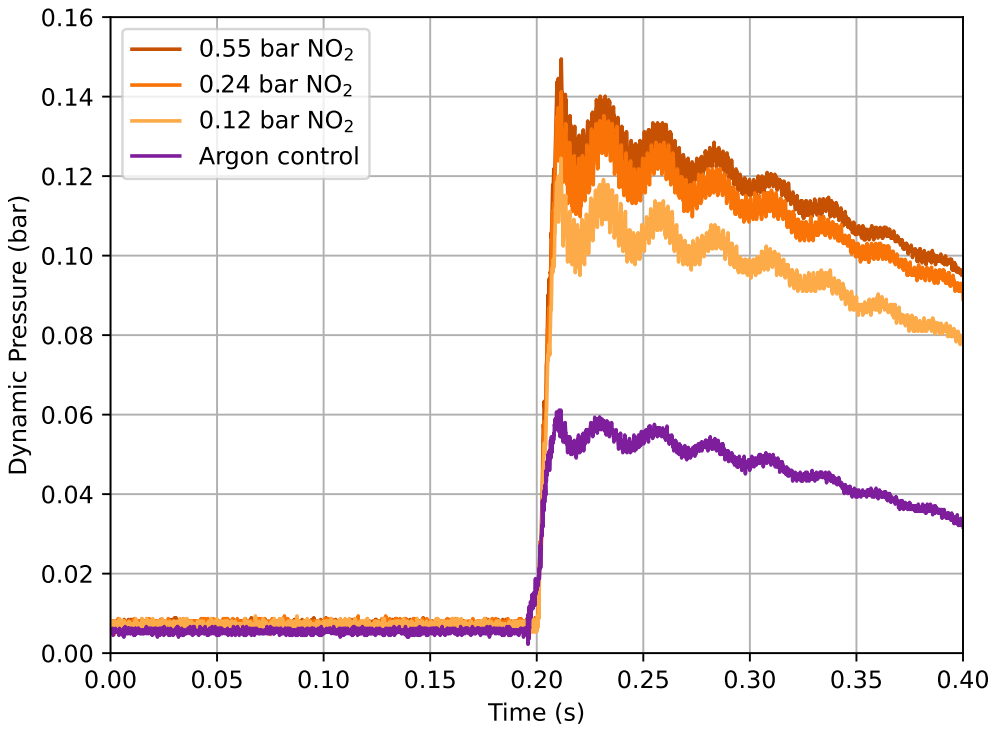
[picture p158: page 1]
Time (s)

0 Argon control | . 1 2 b a r N | O 2

Dynamic Pressure (bar)
