GeeArDee/MScThesis/Thesis/assets/appendices/Omega Calibration.pdf

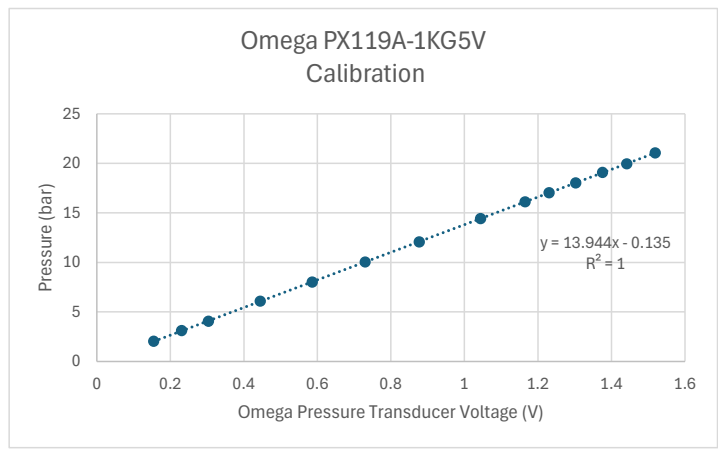
[picture p159: page 1]
1.6 Pressure ⁽bar); Omega PX119A-1KG5V Calibration

Omega Pressure Transducer Voltage (V)
