GeeArDee/MScThesis/Thesis/assets/3 design/V2 Flowing config.pdf

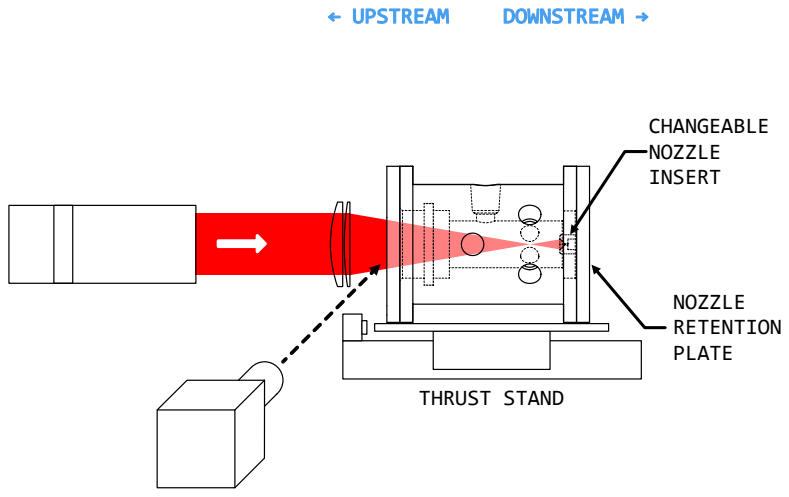
[picture p160: page 1]
← UPSTREAM; DOWNSTREAM →; NOZZLE RETENTION PLATE; CHANGEABLE NOZZLE INSERT; THRUST STAND
