GeeArDee/MScThesis/Thesis/assets/3 design/V2 Static config.pdf

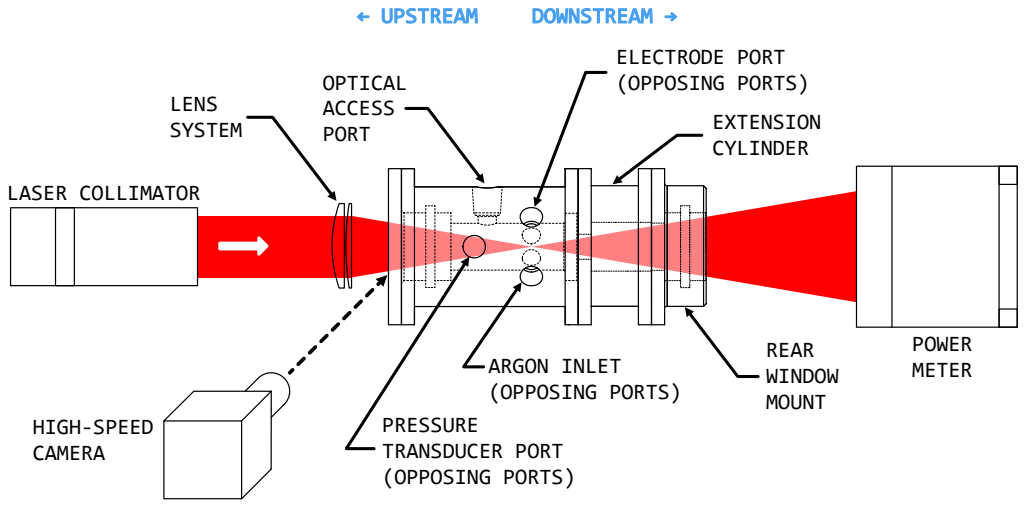
[picture p161: page 1]
HIGH-SPEED CAMERA; POWER METER; LASER COLLIMATOR; LENS SYSTEM; ARGON INLET (OPPOSING PORTS); EXTENSION CYLINDER; ELECTRODE PORT (OPPOSING PORTS); REAR WINDOW MOUNT; OPTICAL ACCESS PORT; PRESSURE TRANSDUCER PORT (OPPOSING PORTS); ← UPSTREAM; DOWNSTREAM →
