GeeArDee/MScThesis/Thesis/assets/4 experiments/beam_focus_threshold.pdf

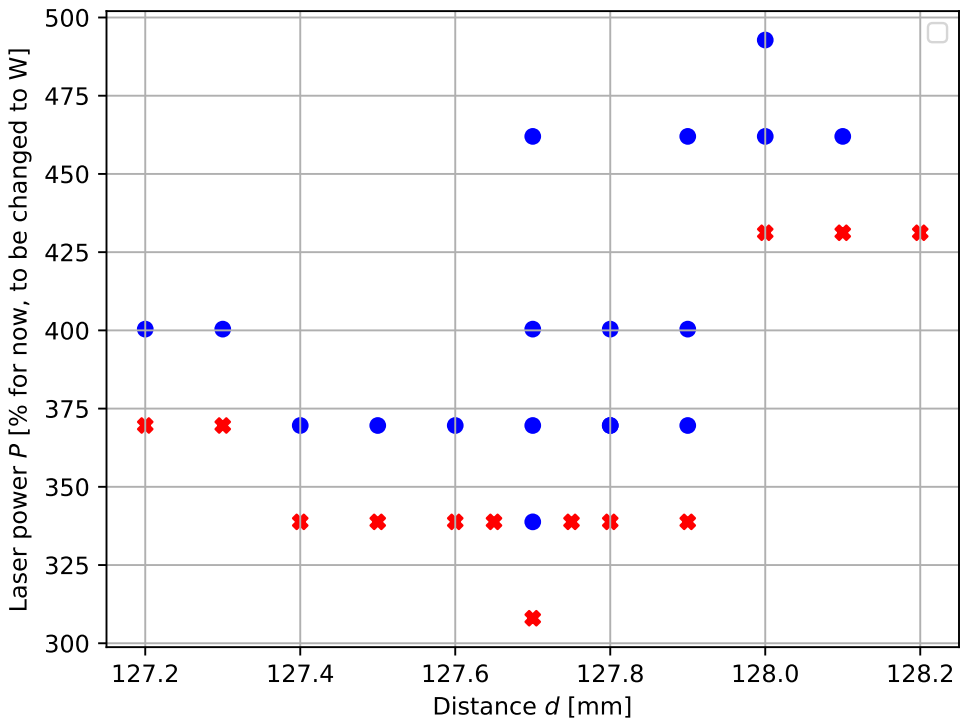
[picture p162: page 1]
128.2 Distance d [mm]

Laser power P [% for now, to be changed to W]
