GeeArDee/MScThesis/Thesis/assets/2 models/LSP183_SPRK54.pdf

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

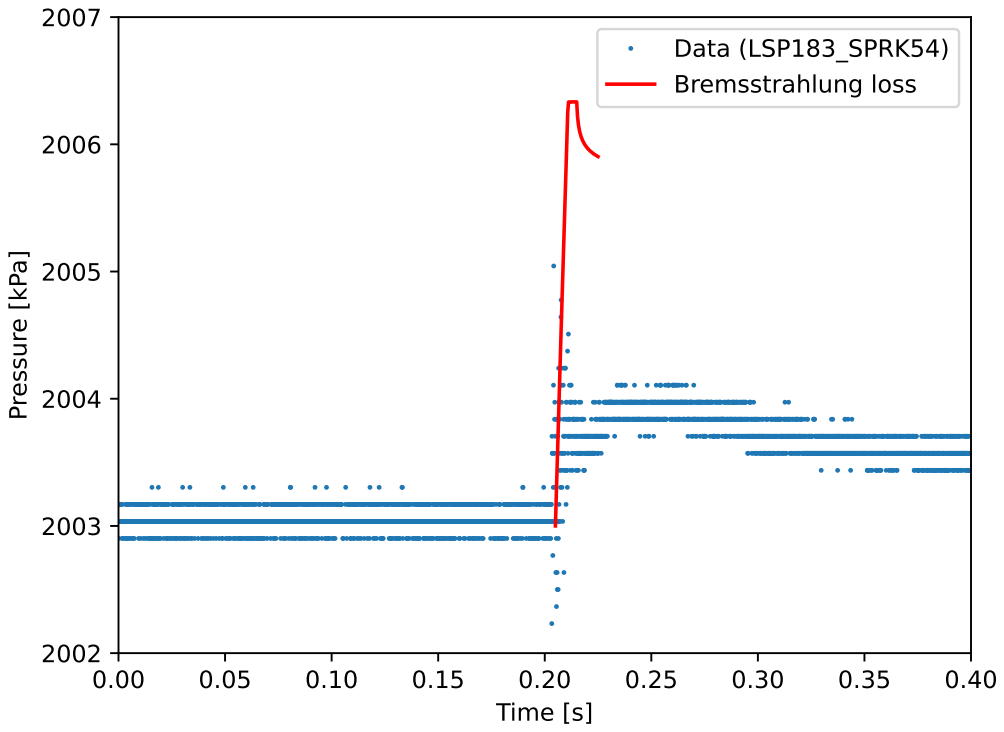
[picture p166: page 1]
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
