GeeArDee/MScThesis/Thesis/assets/4 experiments/duallens_focus_threshold.pdf

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

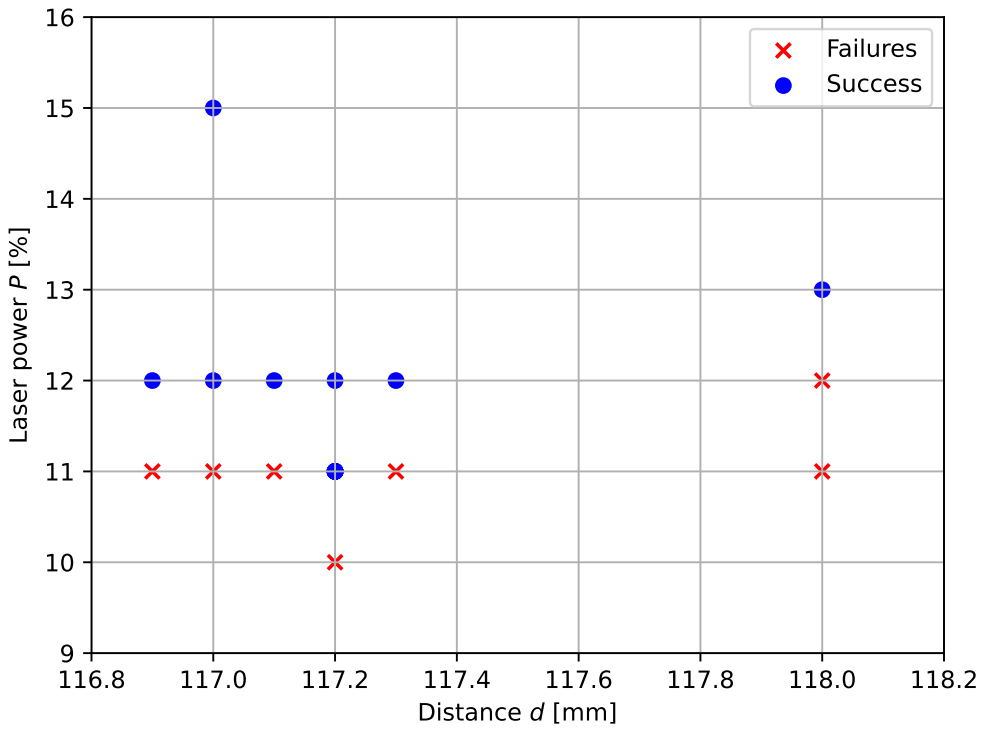
[picture p169: page 1]
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
