GeeArDee/MScThesis/Thesis/assets/4 experiments/hysterisis graph.pdf

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

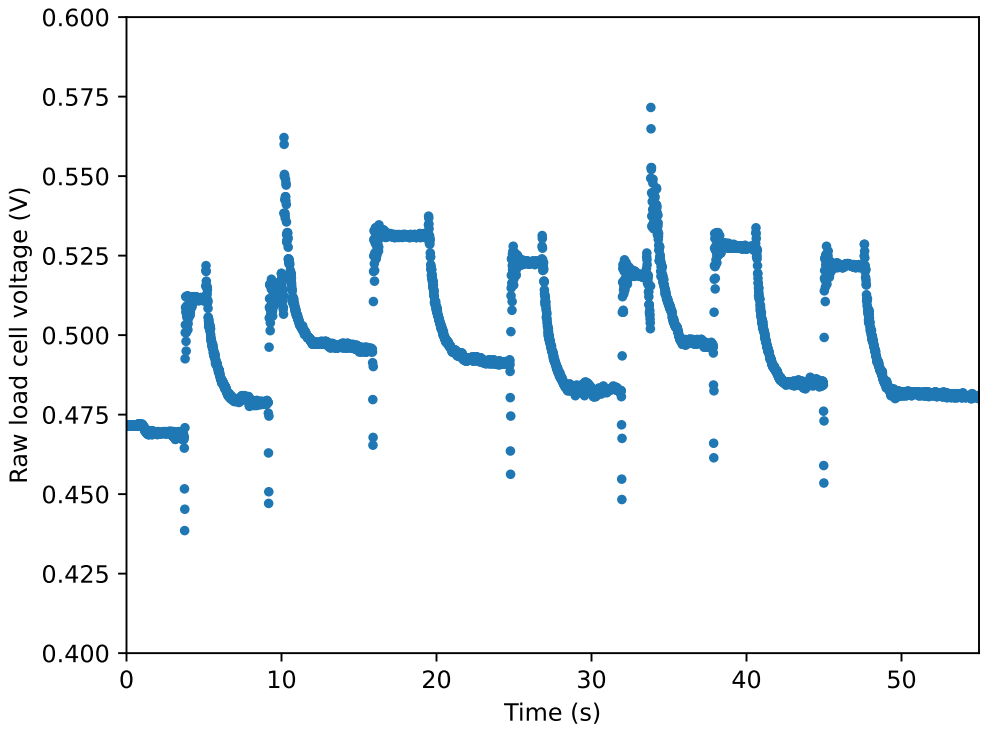
[picture p172: page 1]
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
