GeeArDee/MScThesis/Thesis/assets/2 models/Cp_compare.pdf

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

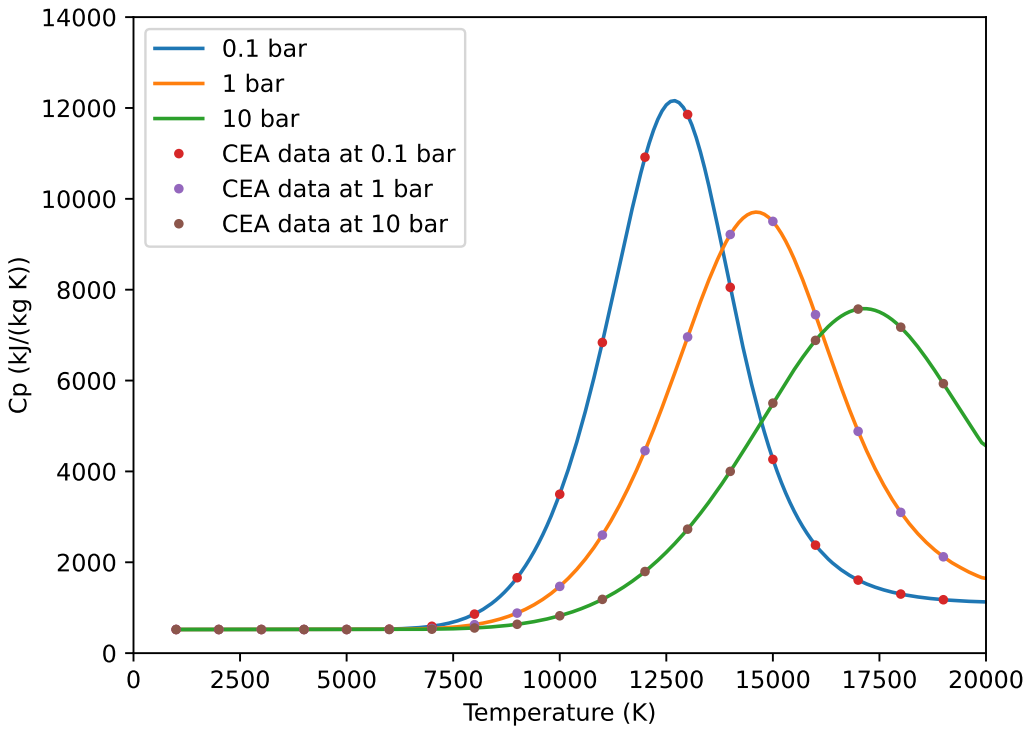
[picture p174: page 1]
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
