GeeArDee/MScThesis/Thesis/assets/appendices/Test Apparatus.pdf

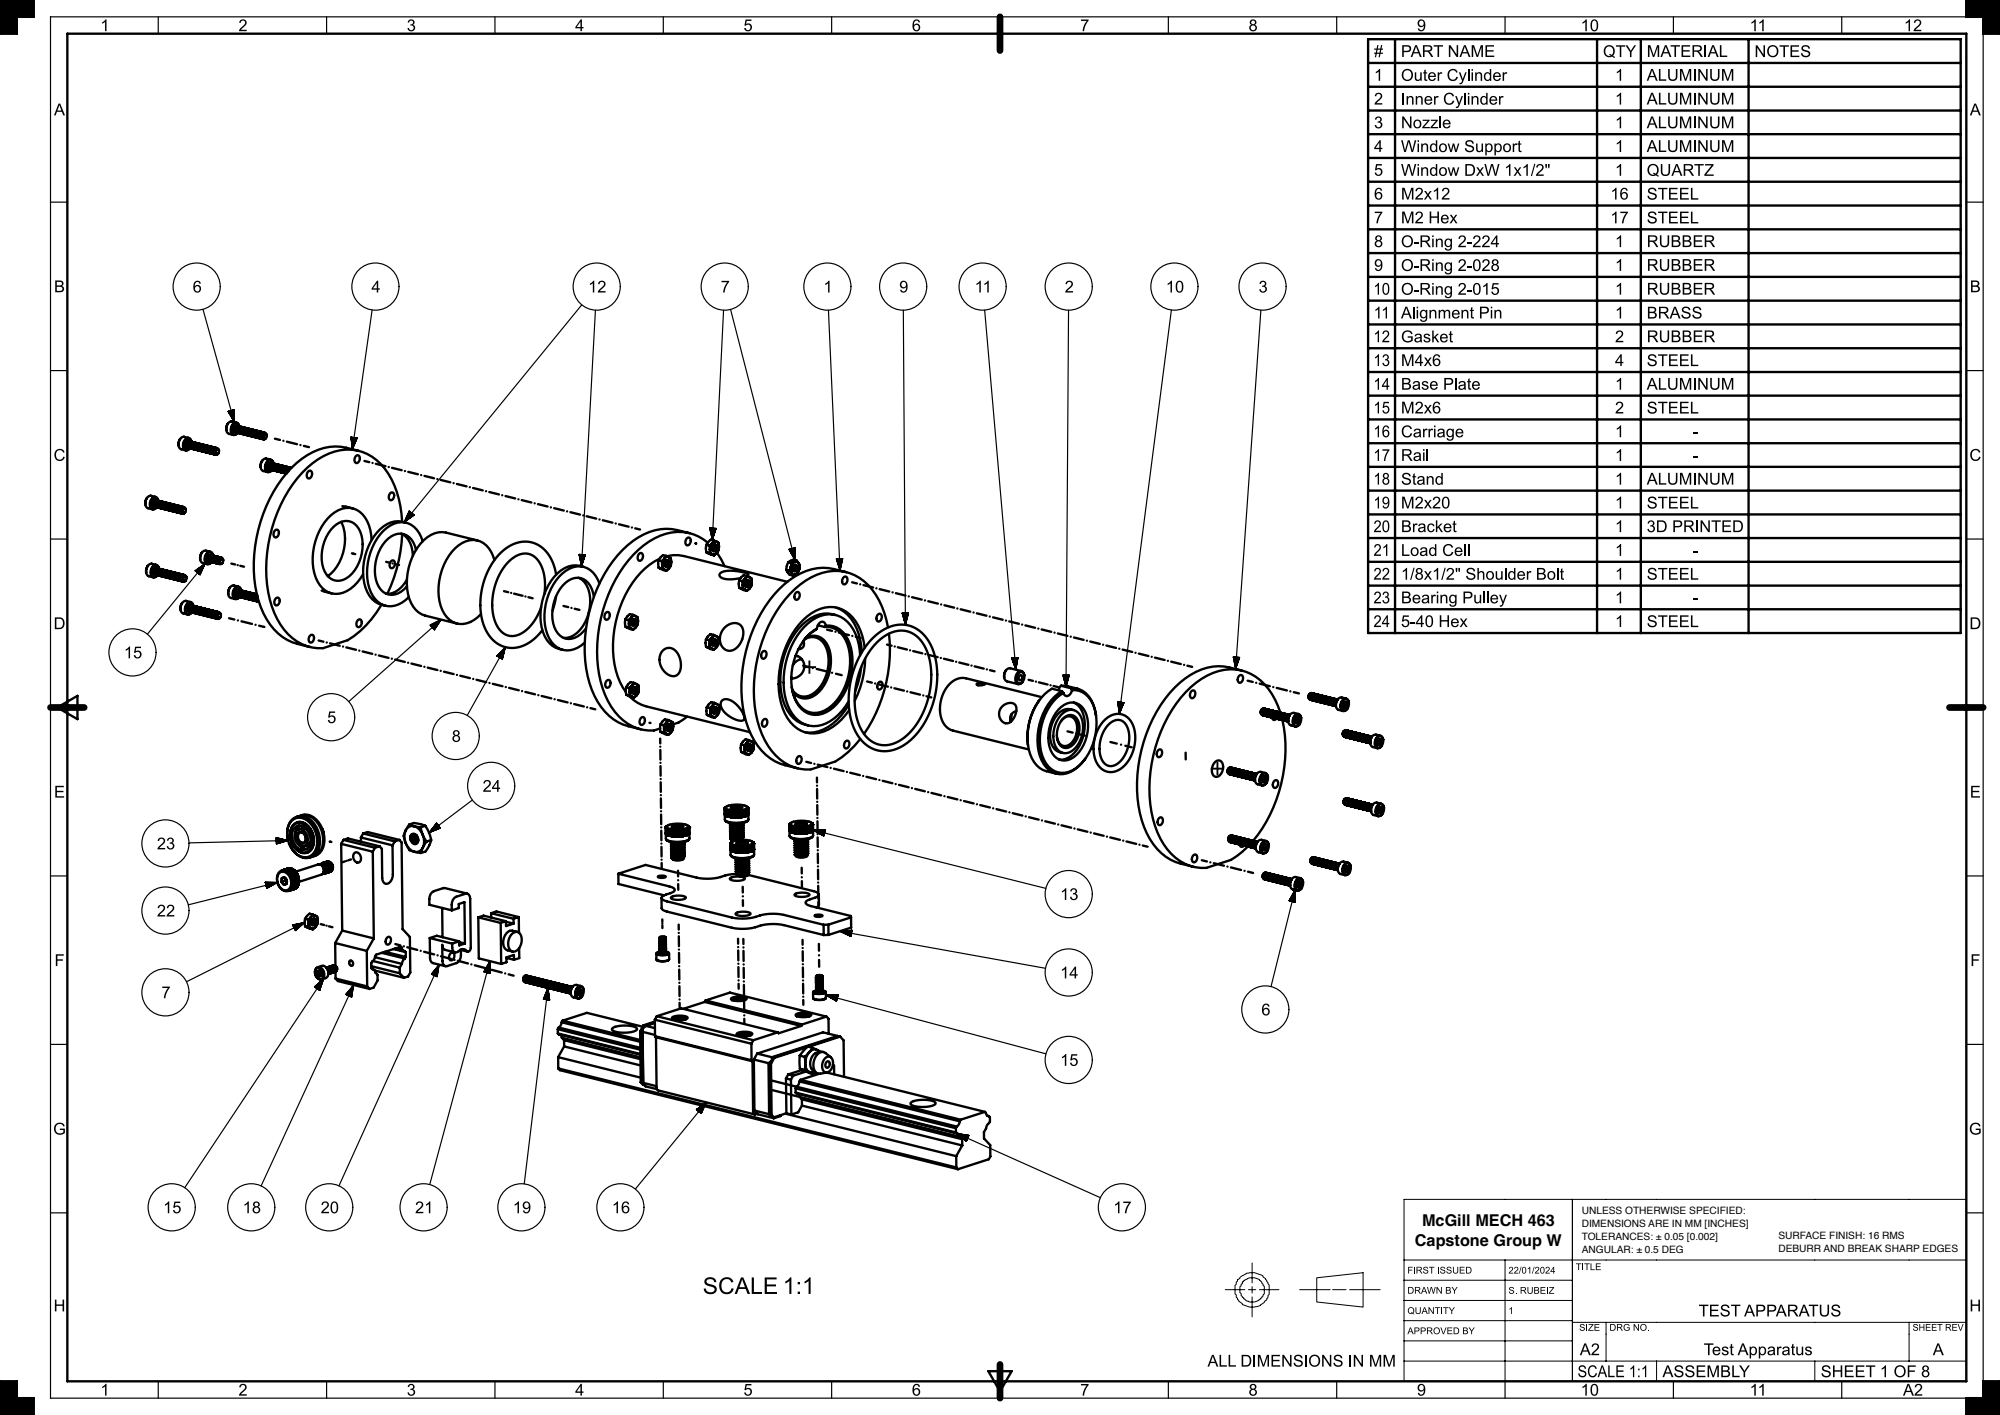
[picture p177: page 1]

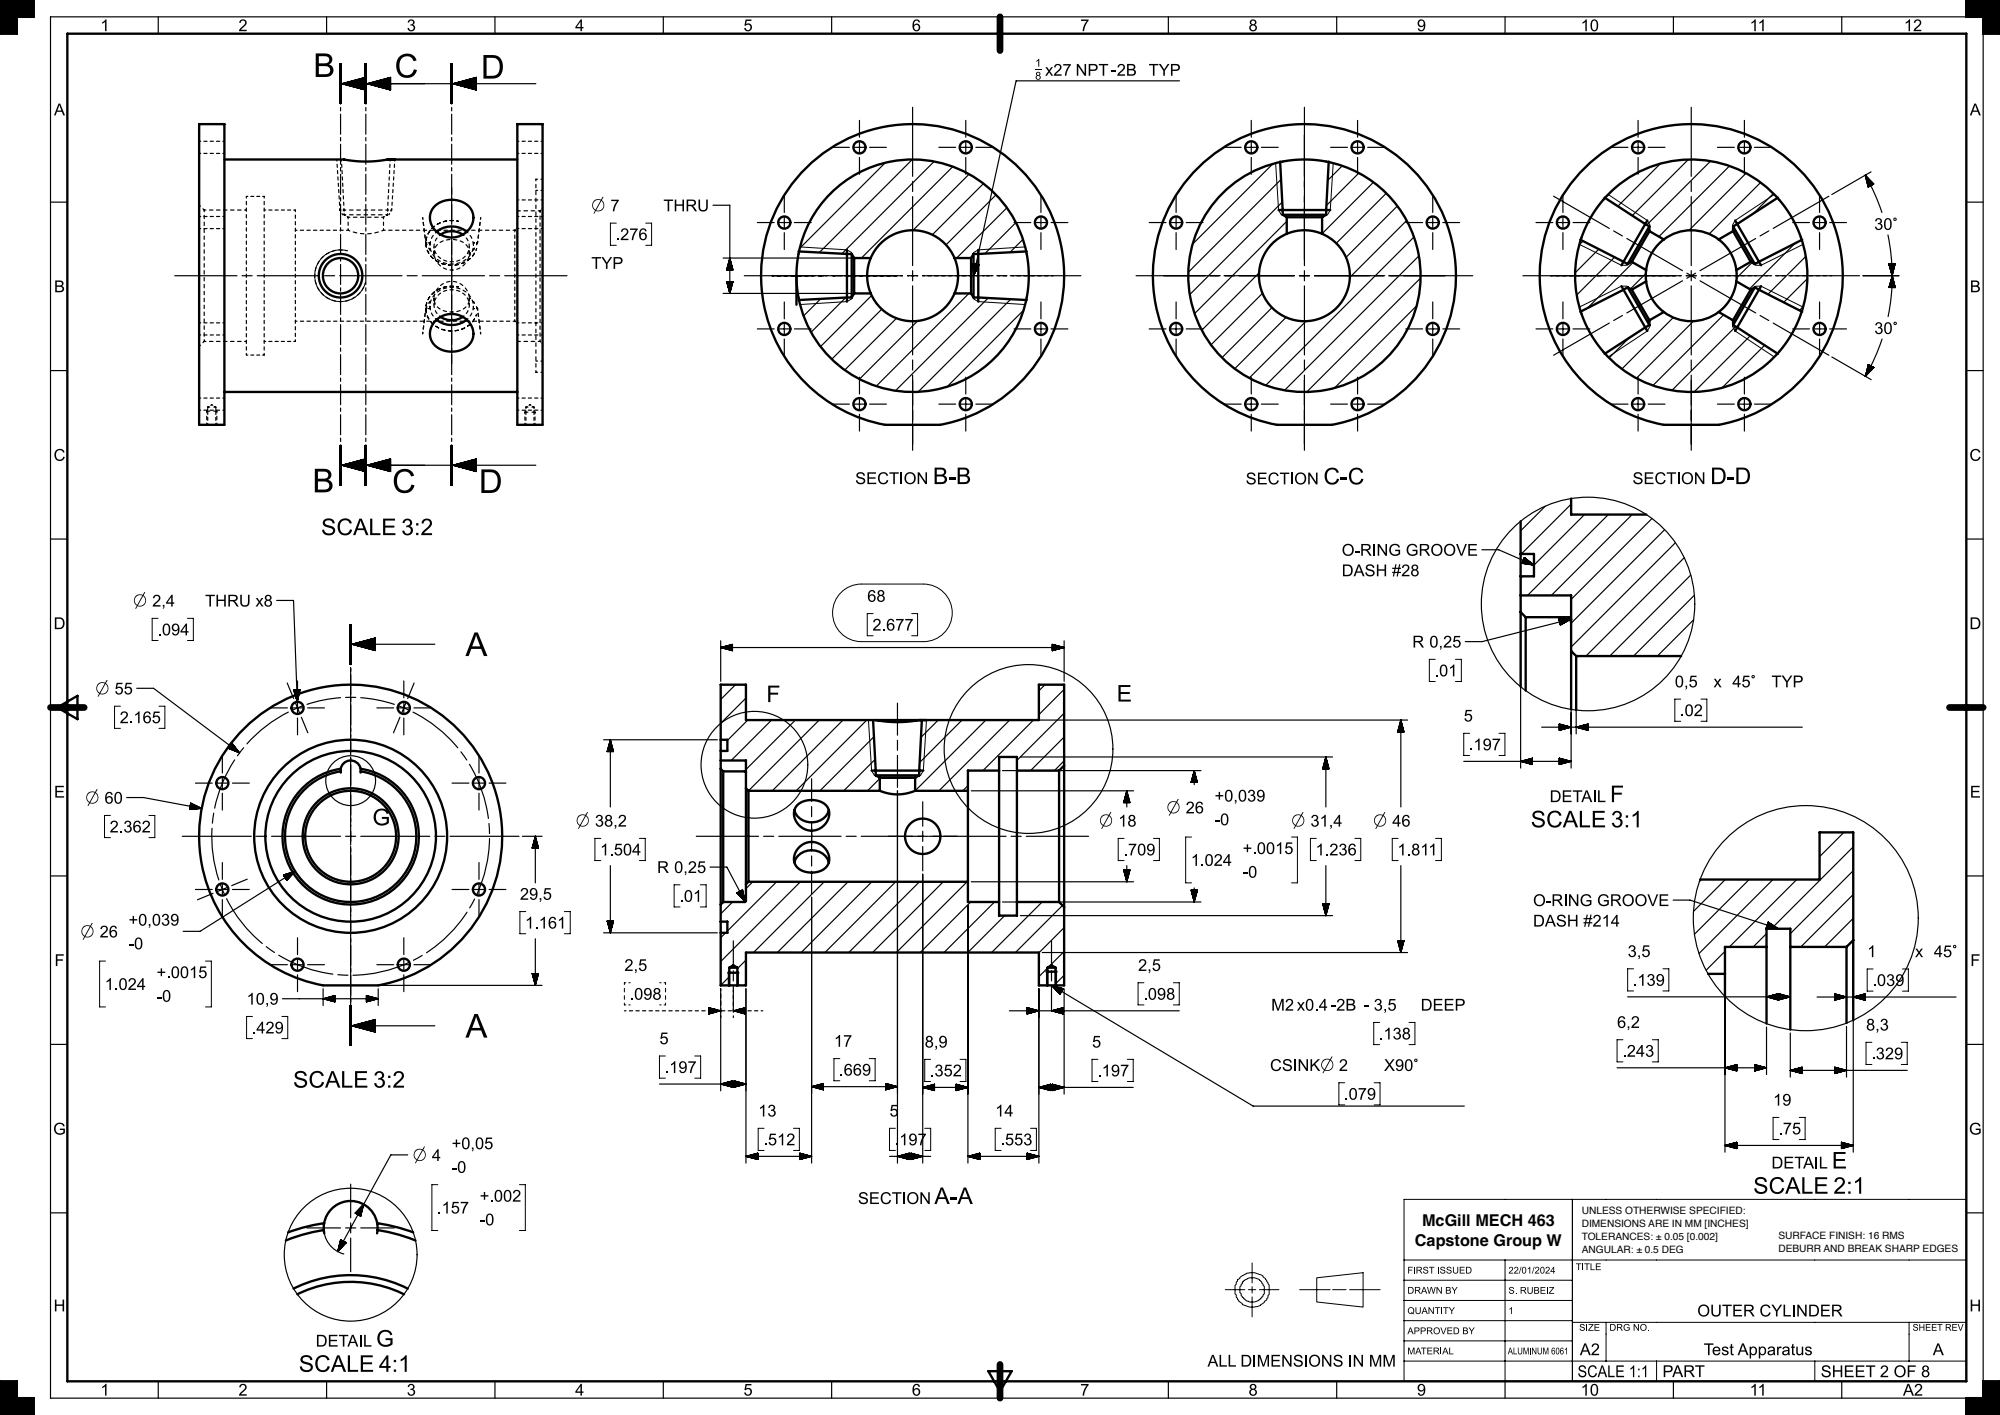
[picture p178: page 2]

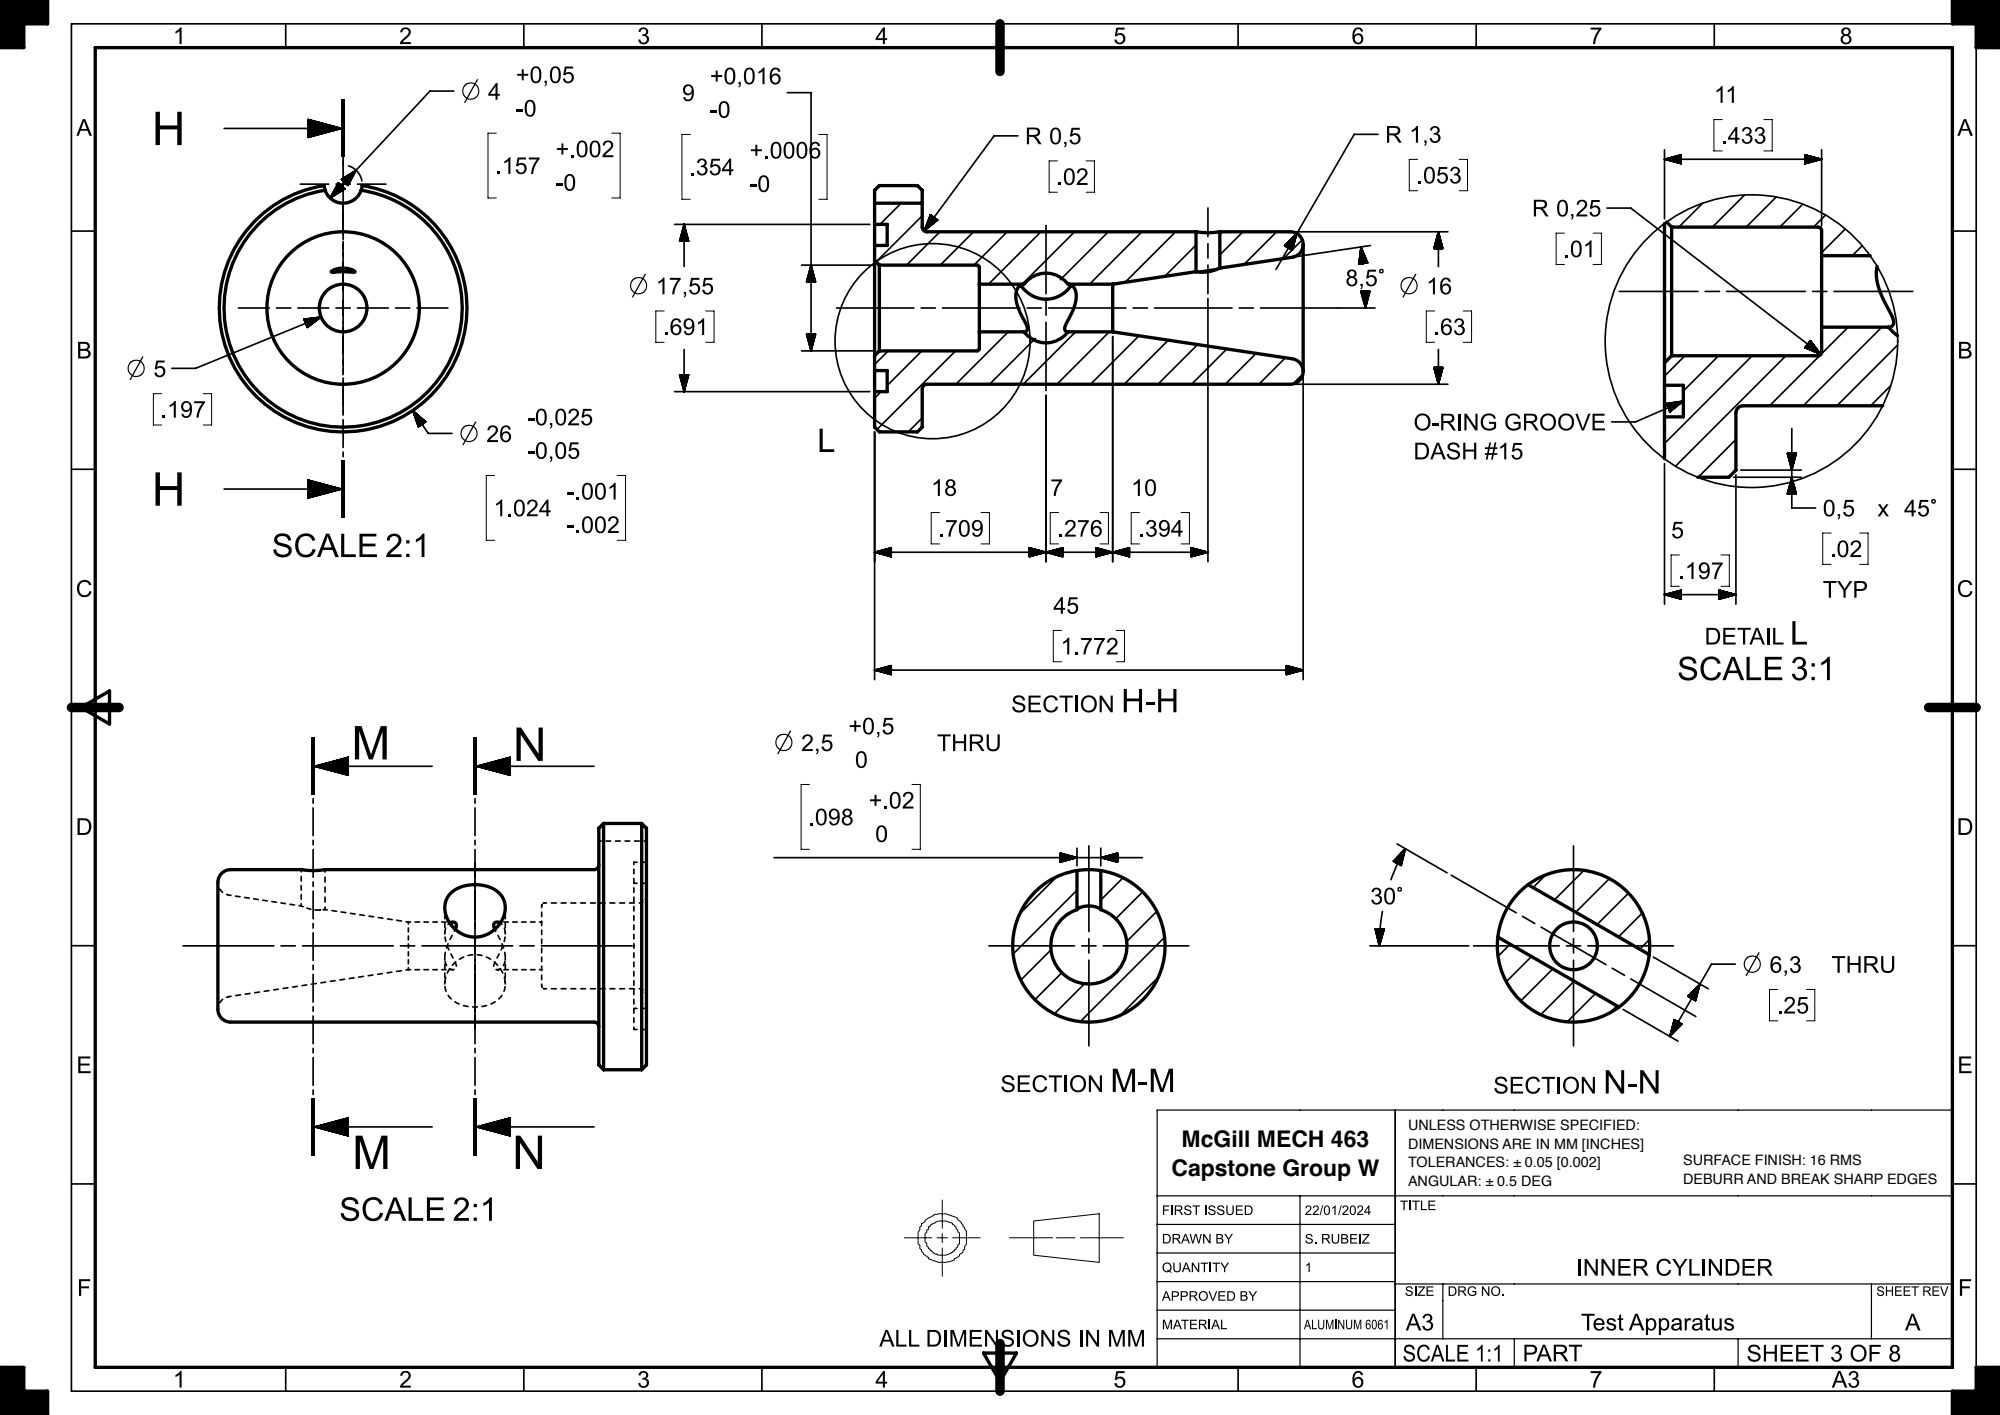
[picture p179: page 3]

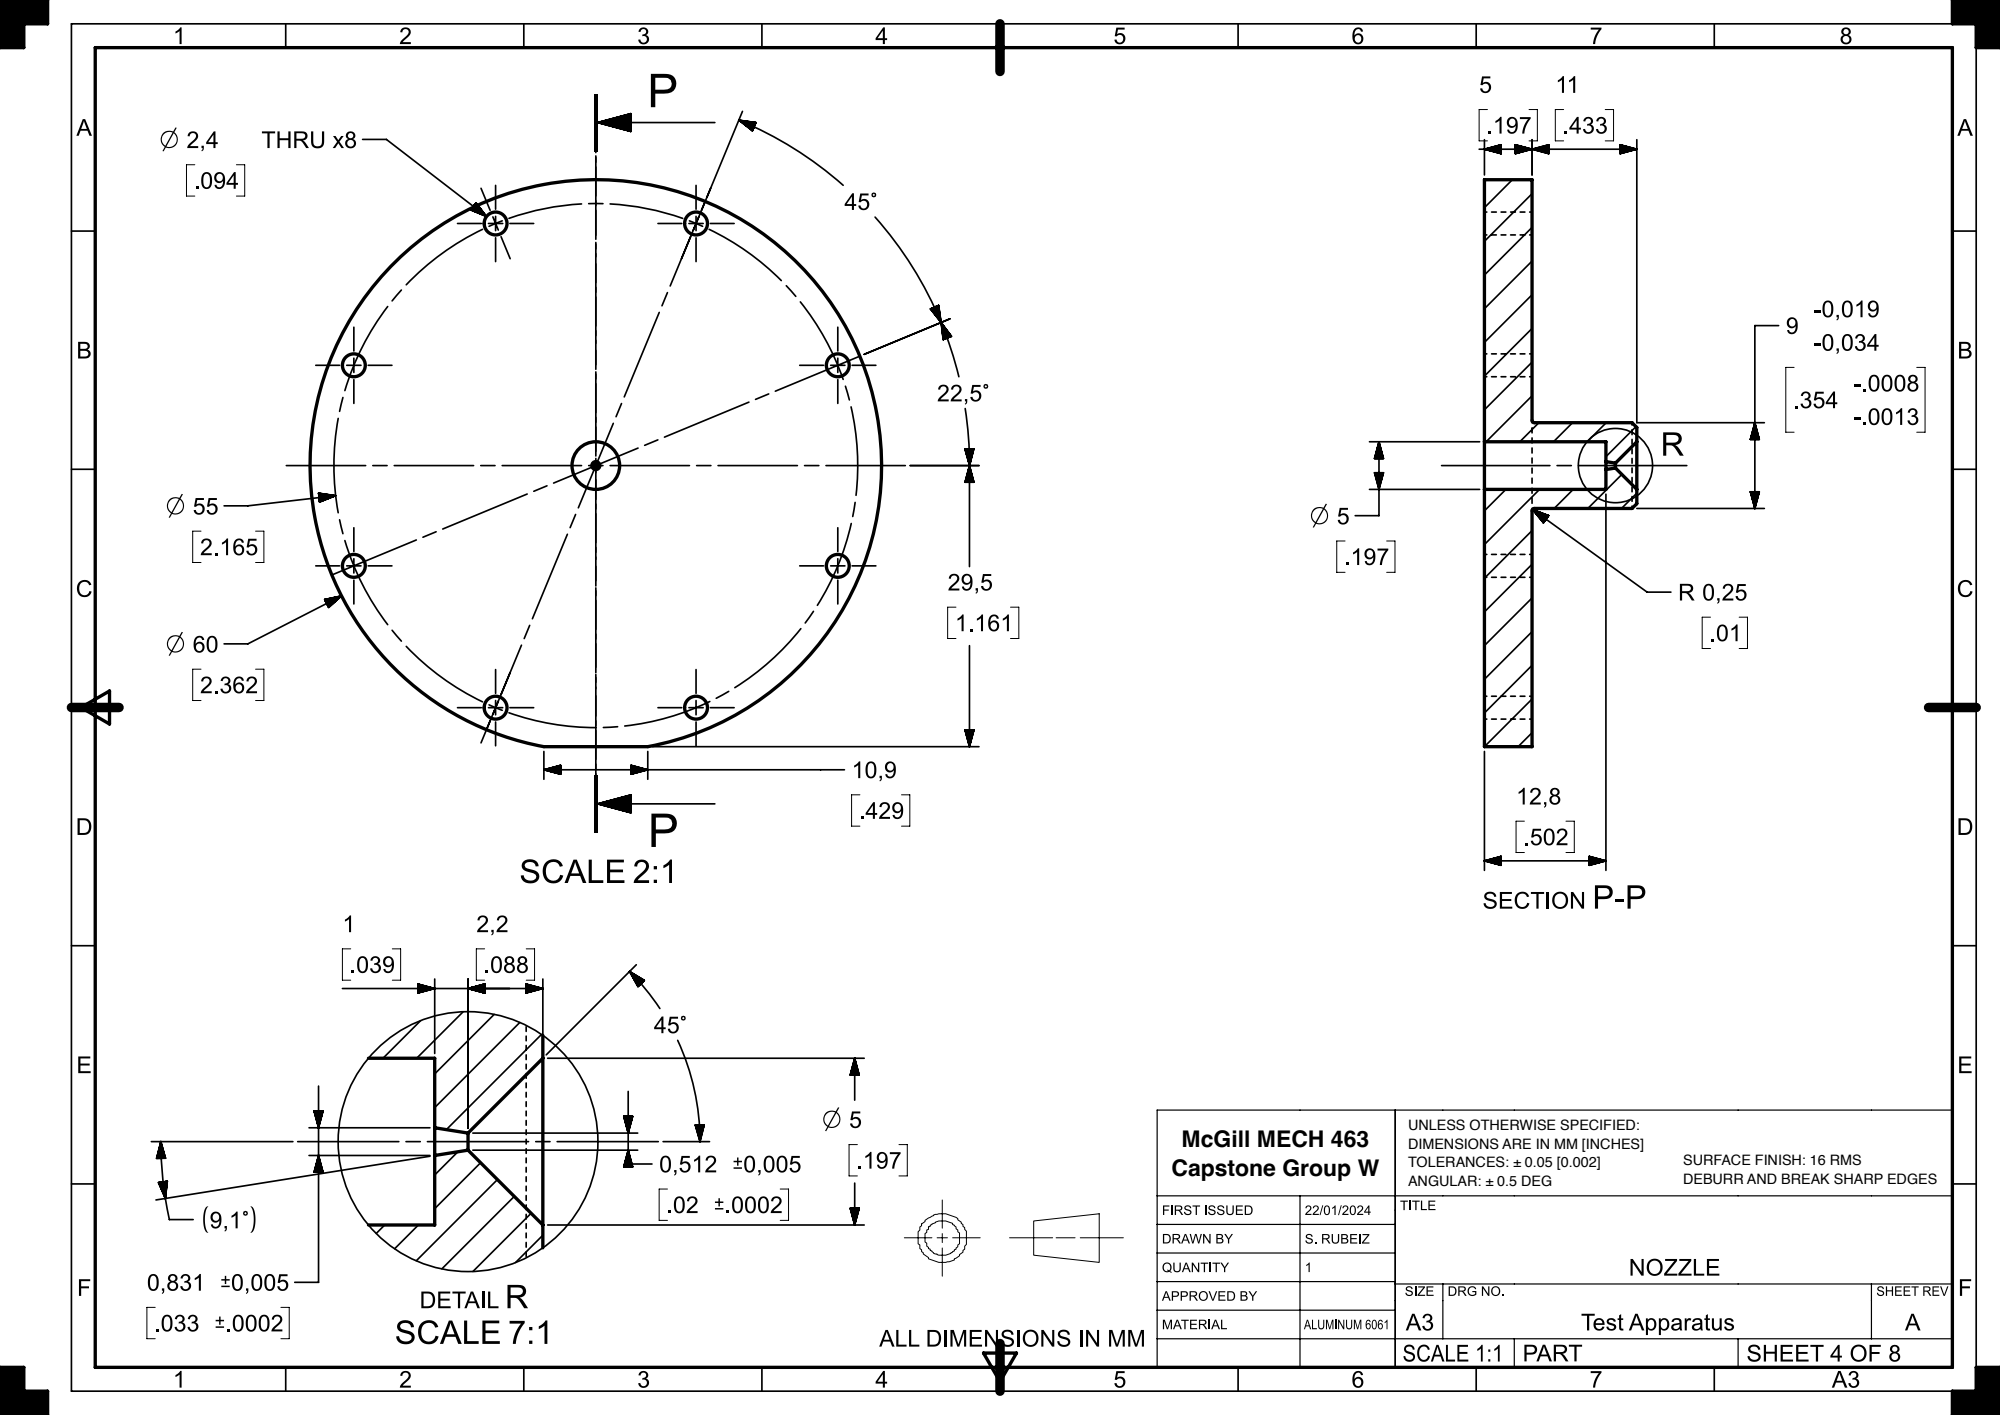
[picture p180: page 4]

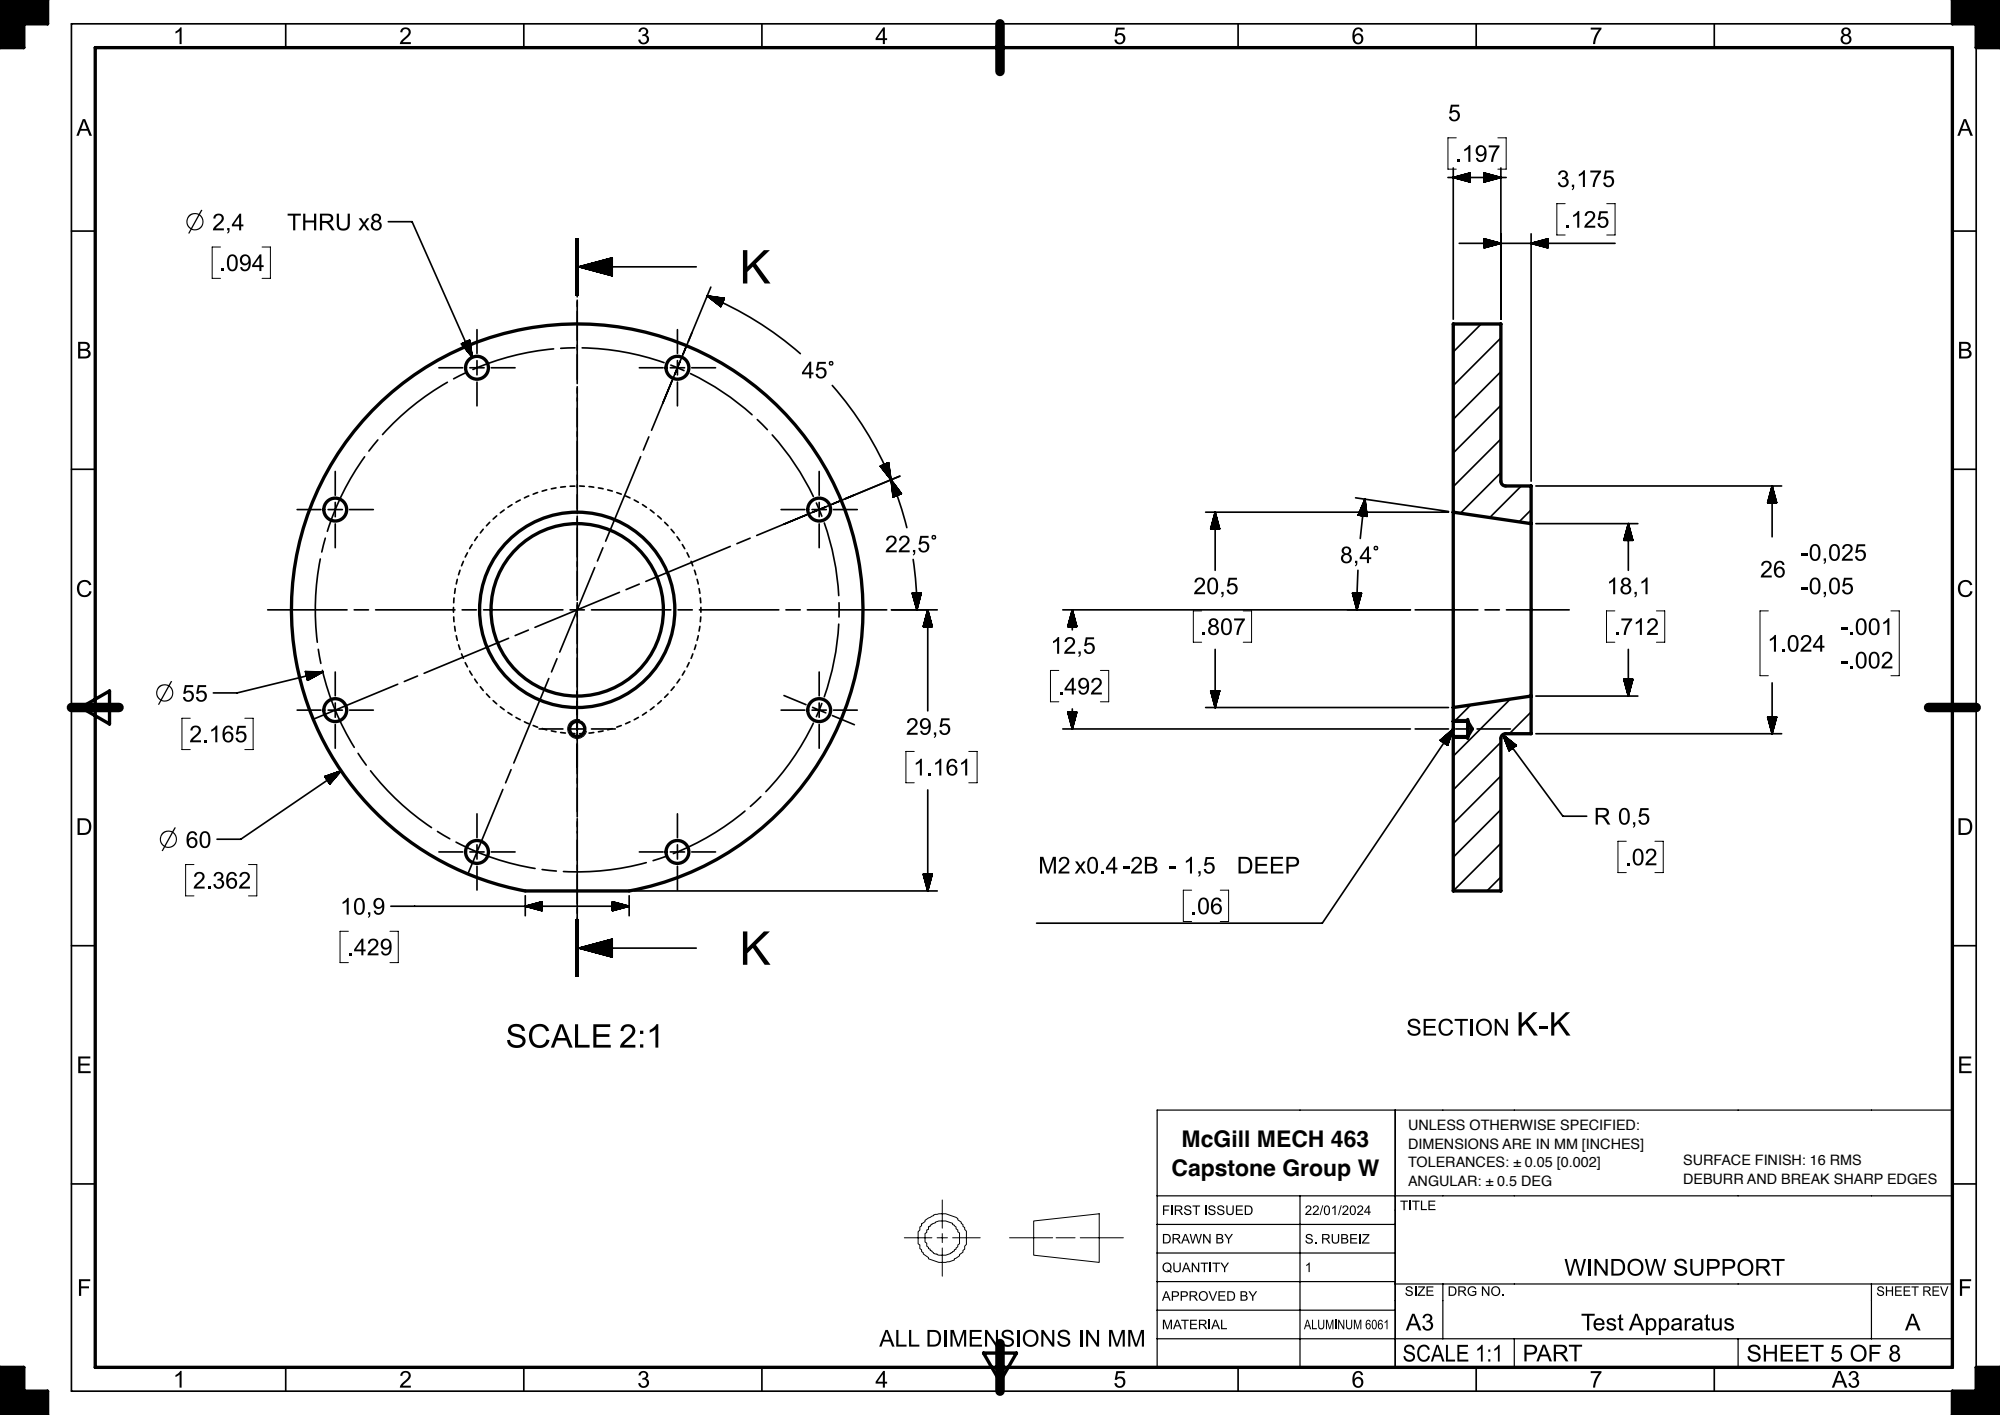
[picture p181: page 5]

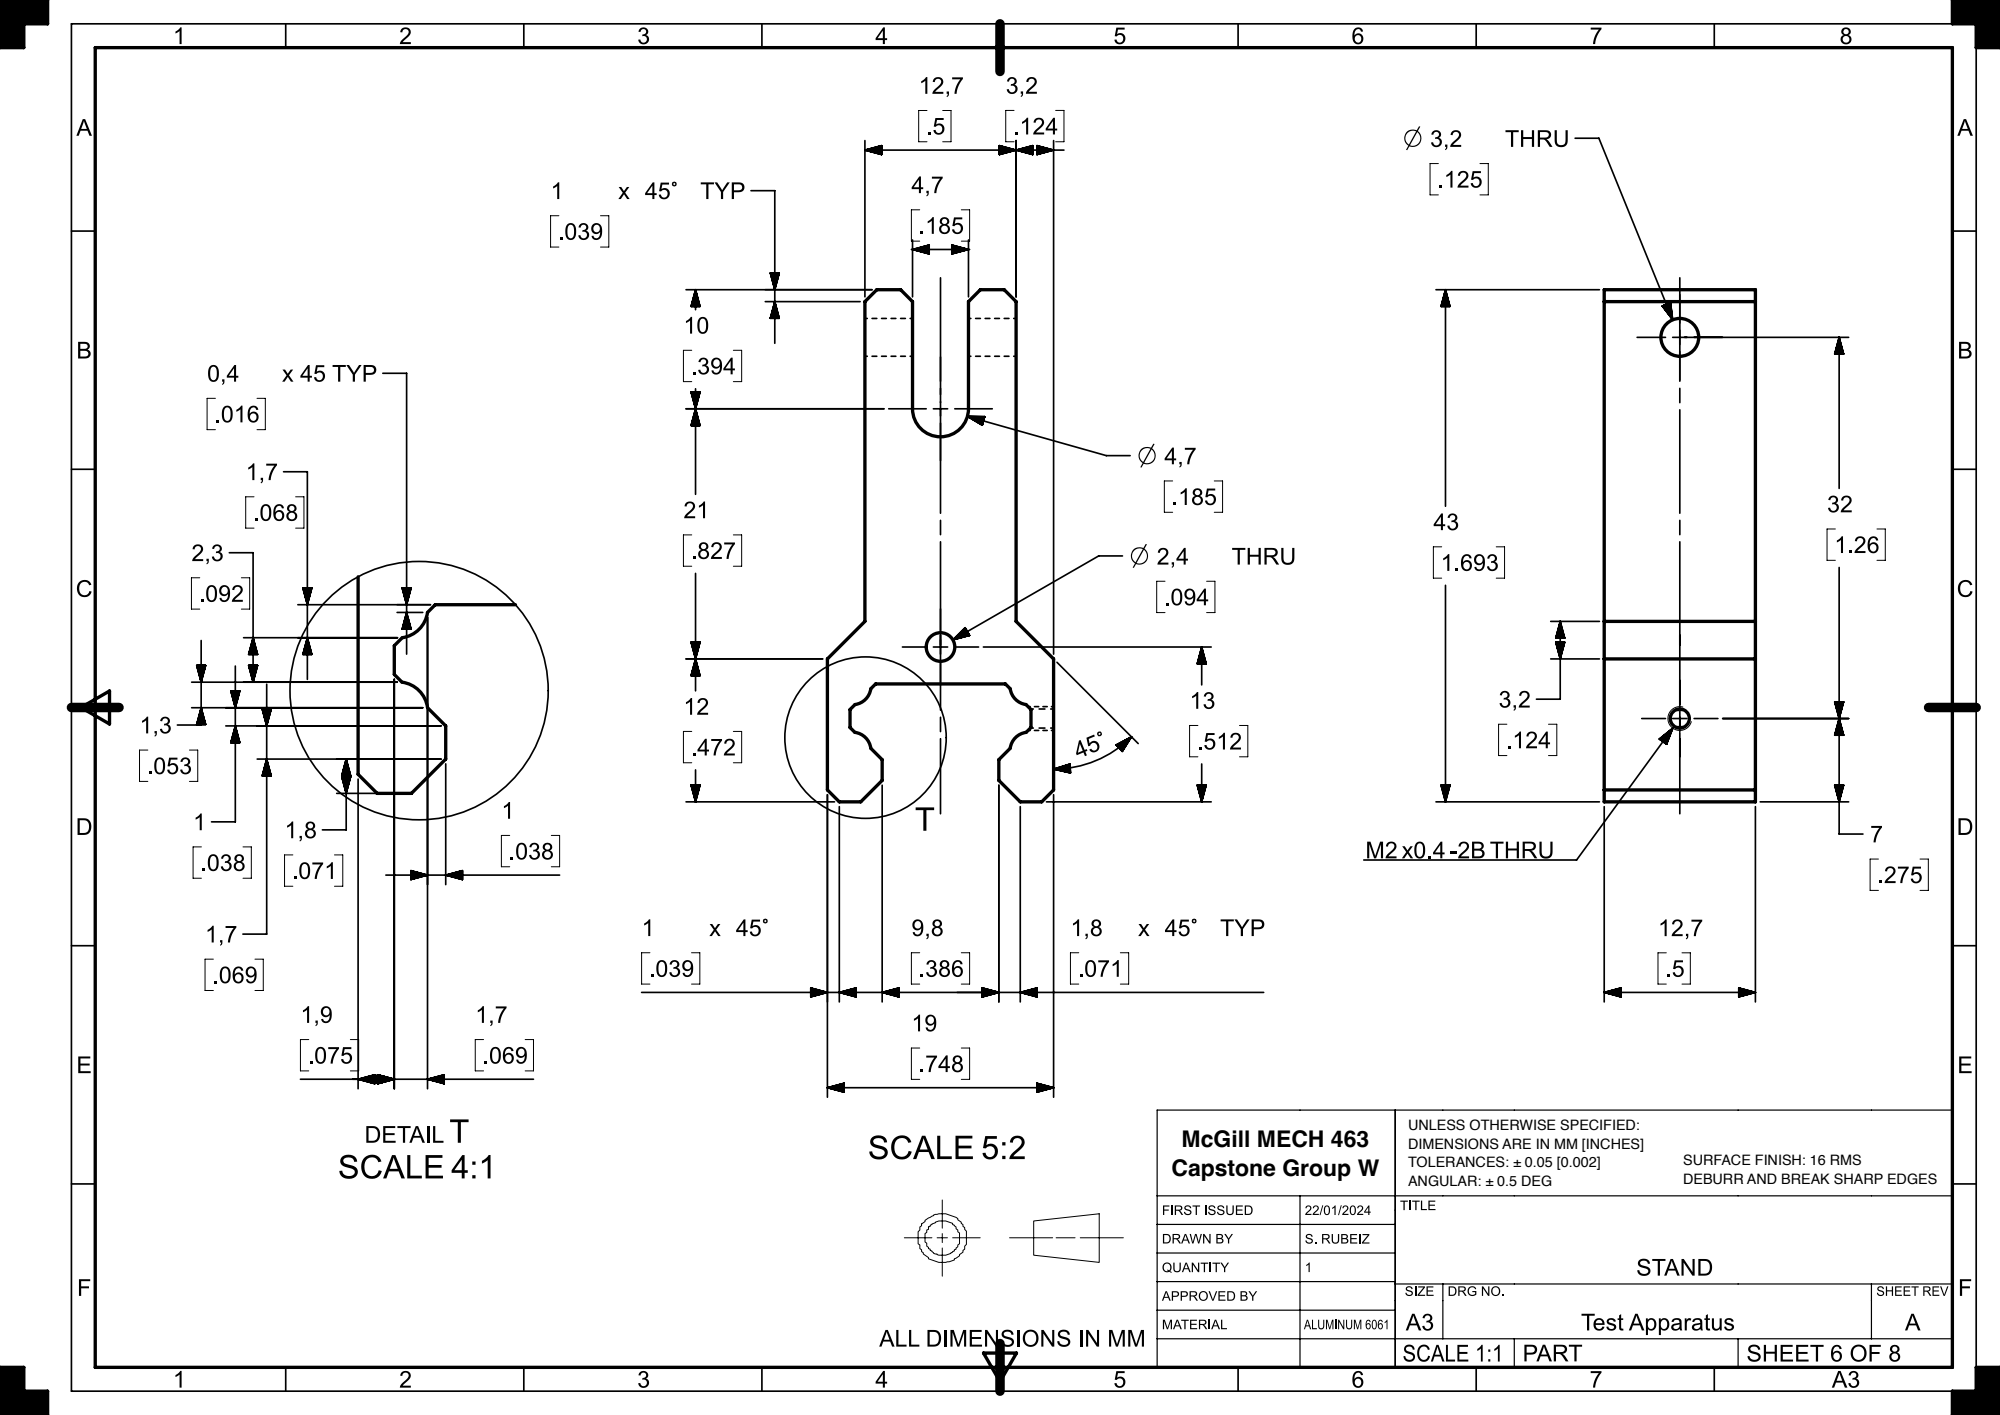
[picture p182: page 6]

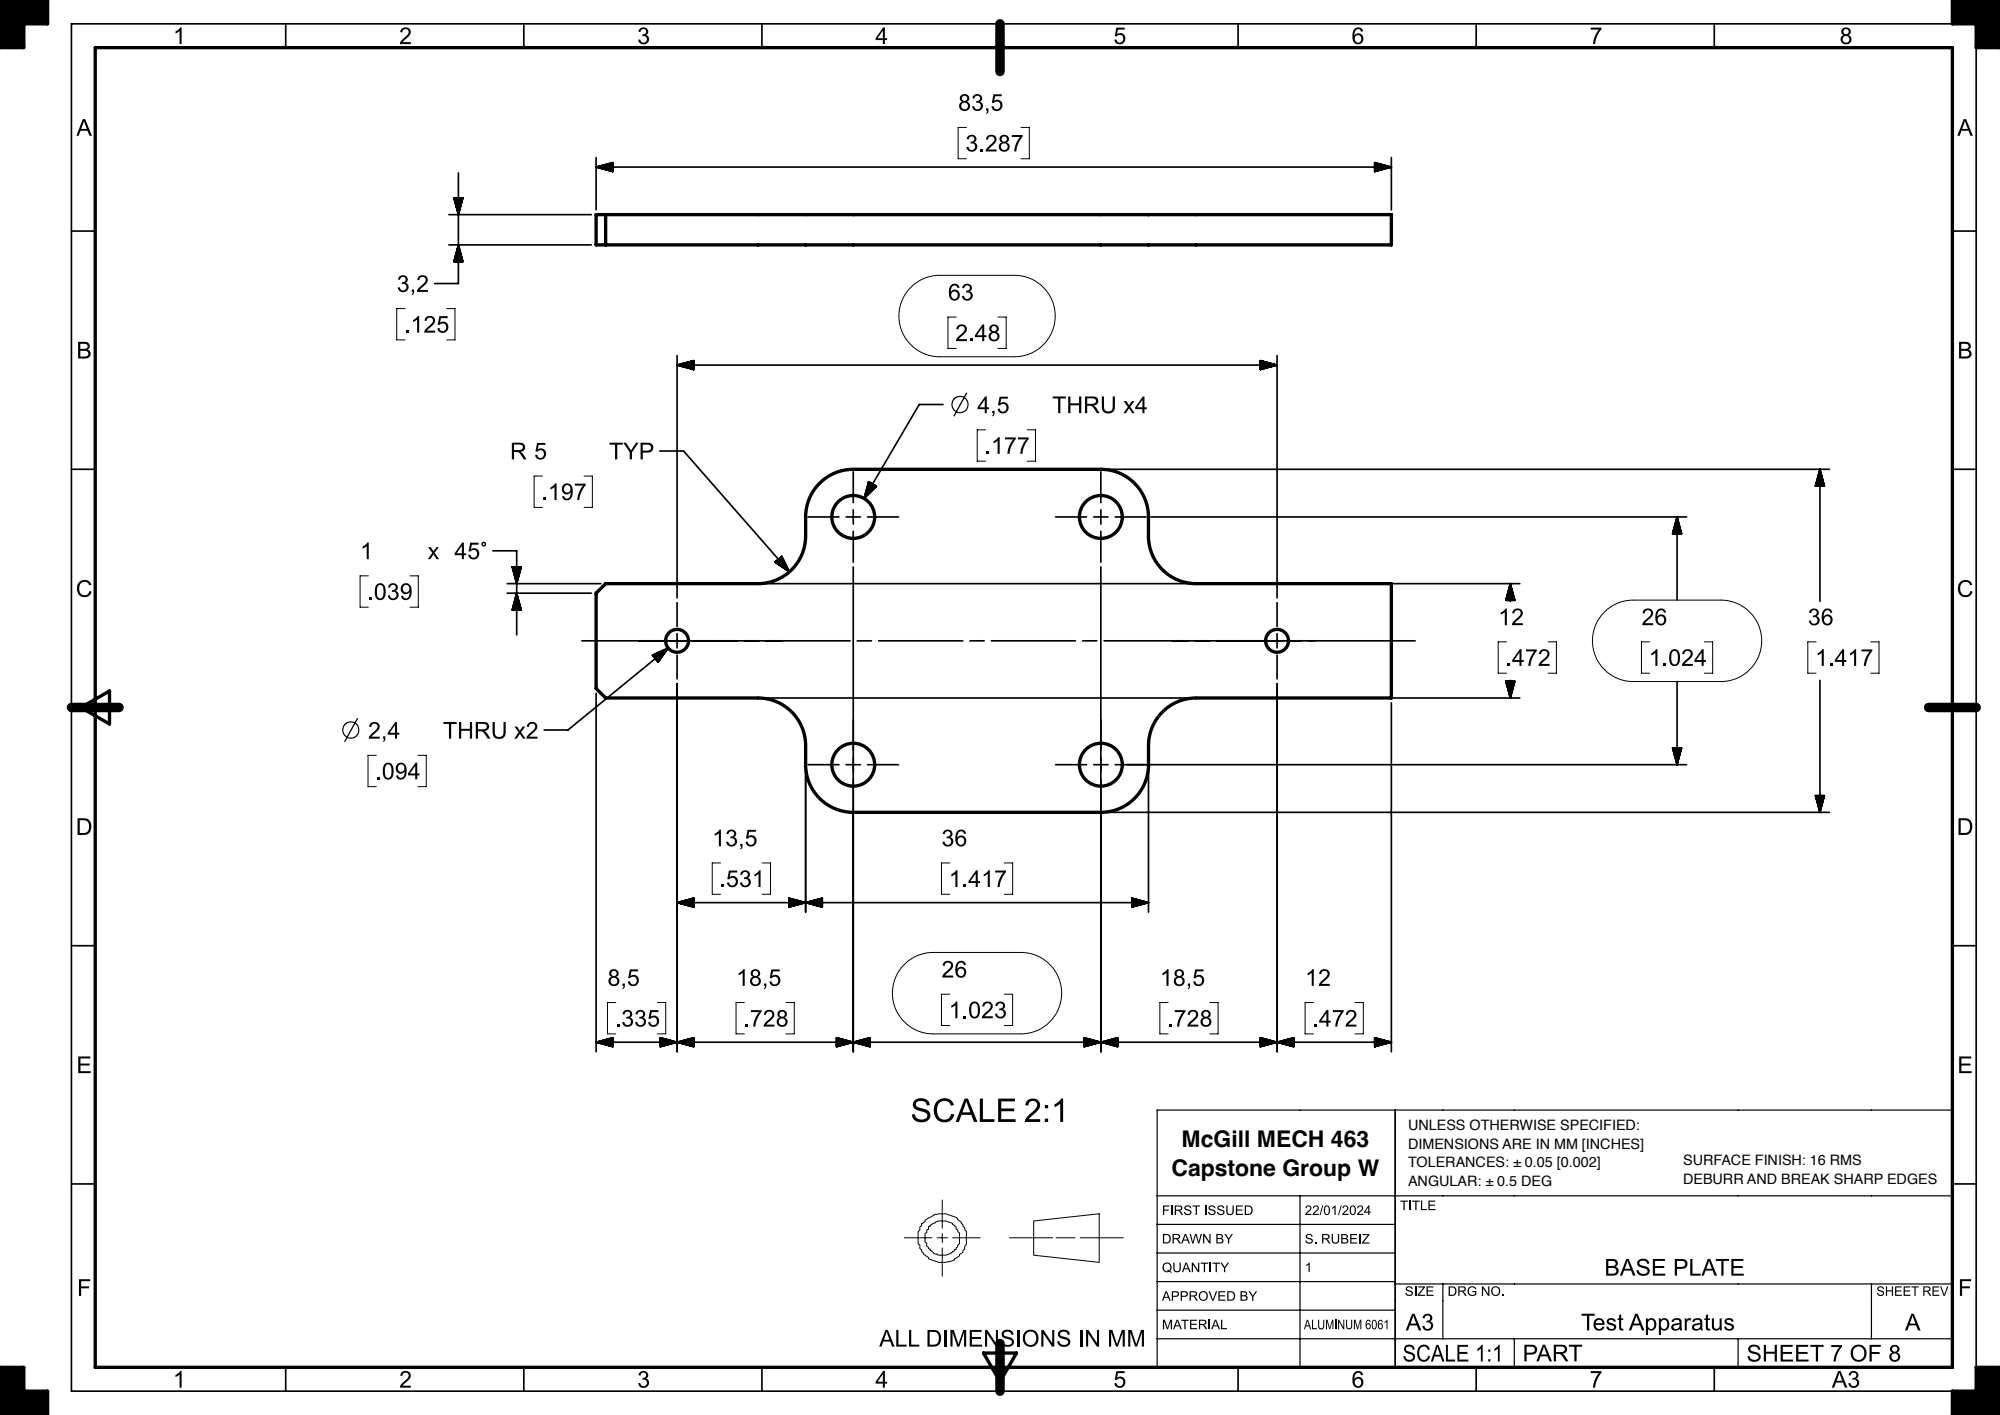
[picture p183: page 7]

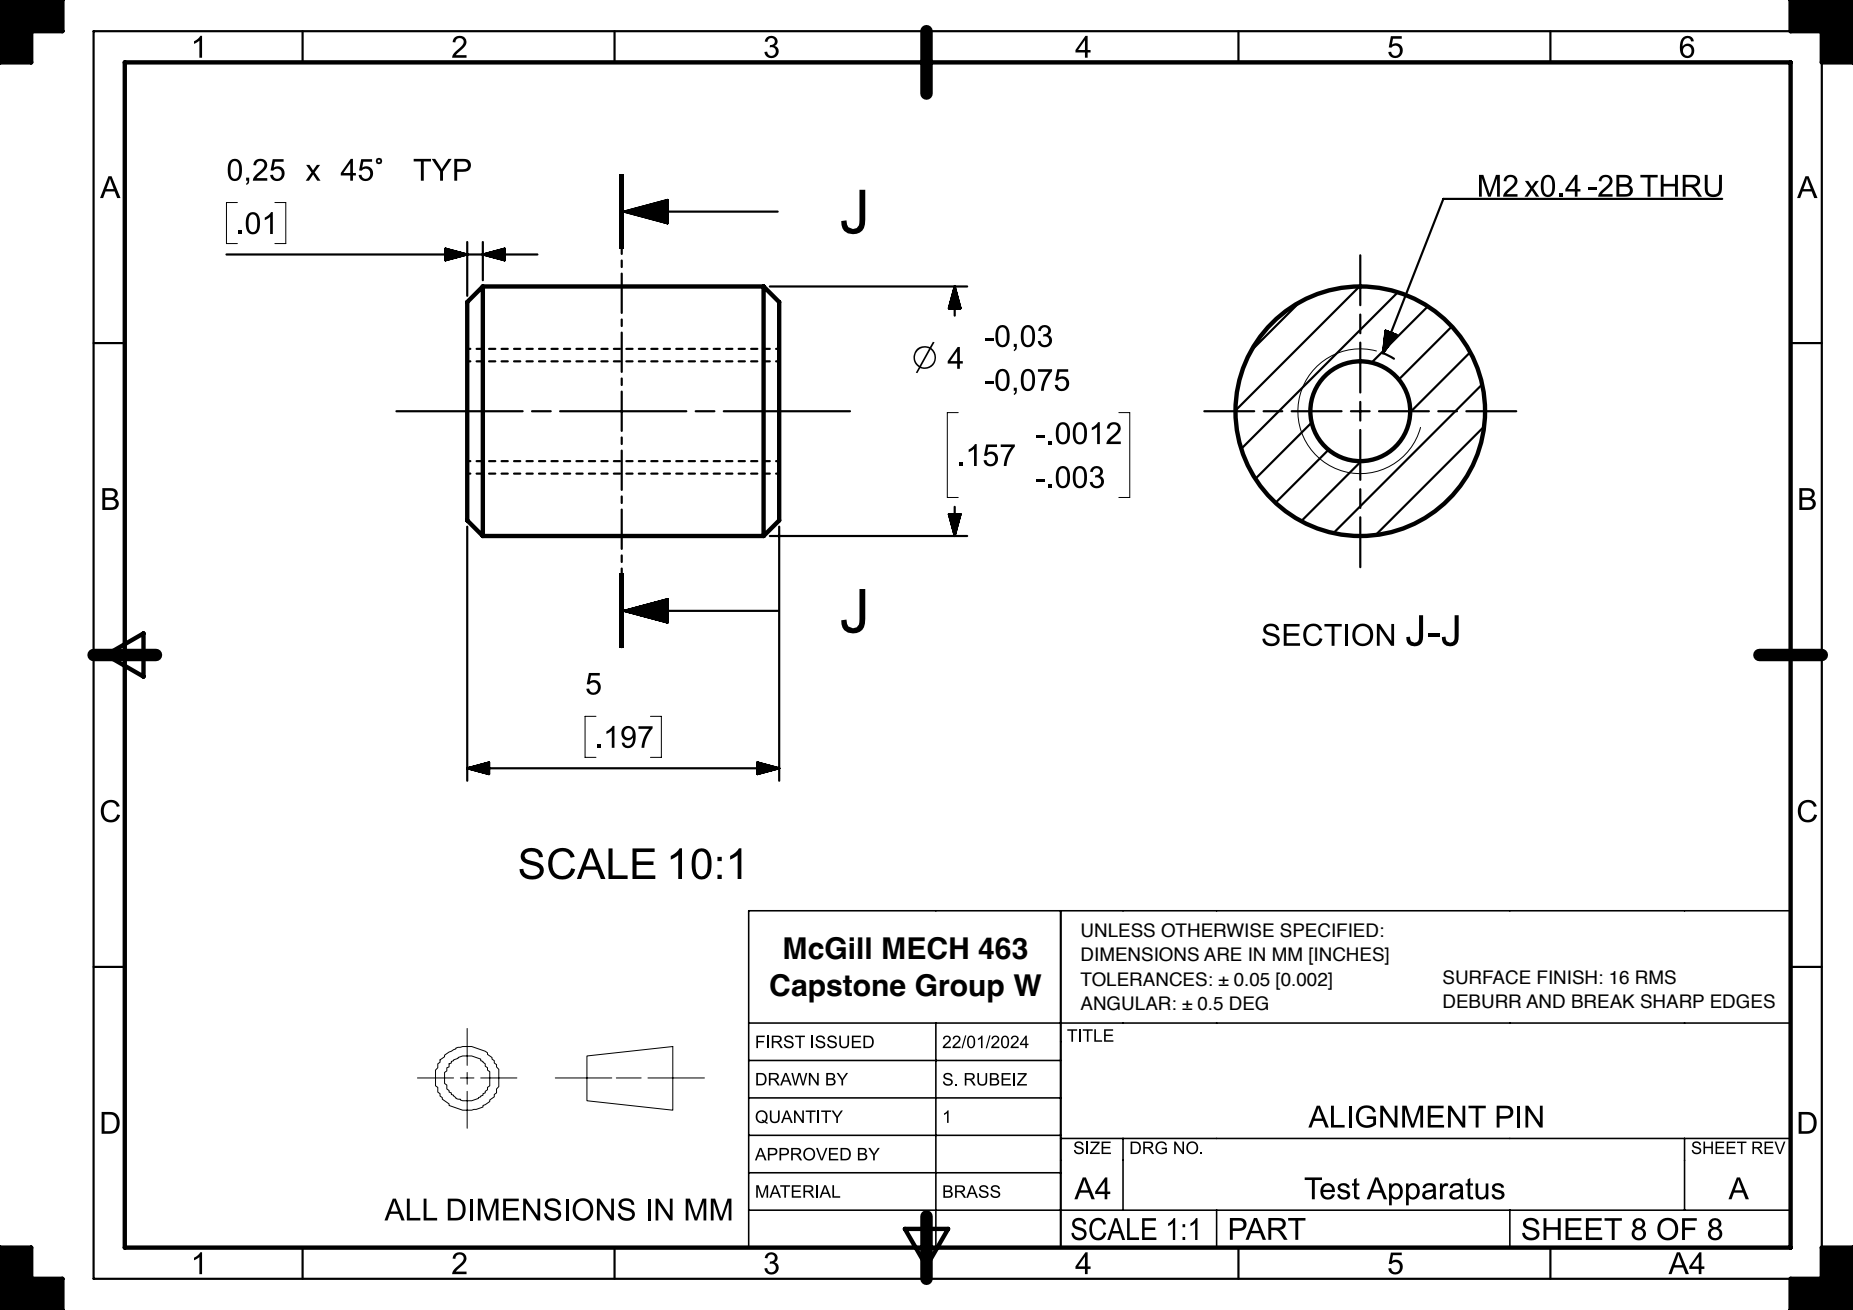
[picture p184: page 8]
