GeeArDee/MScThesis/Thesis/assets/4 experiments/125lens.pdf

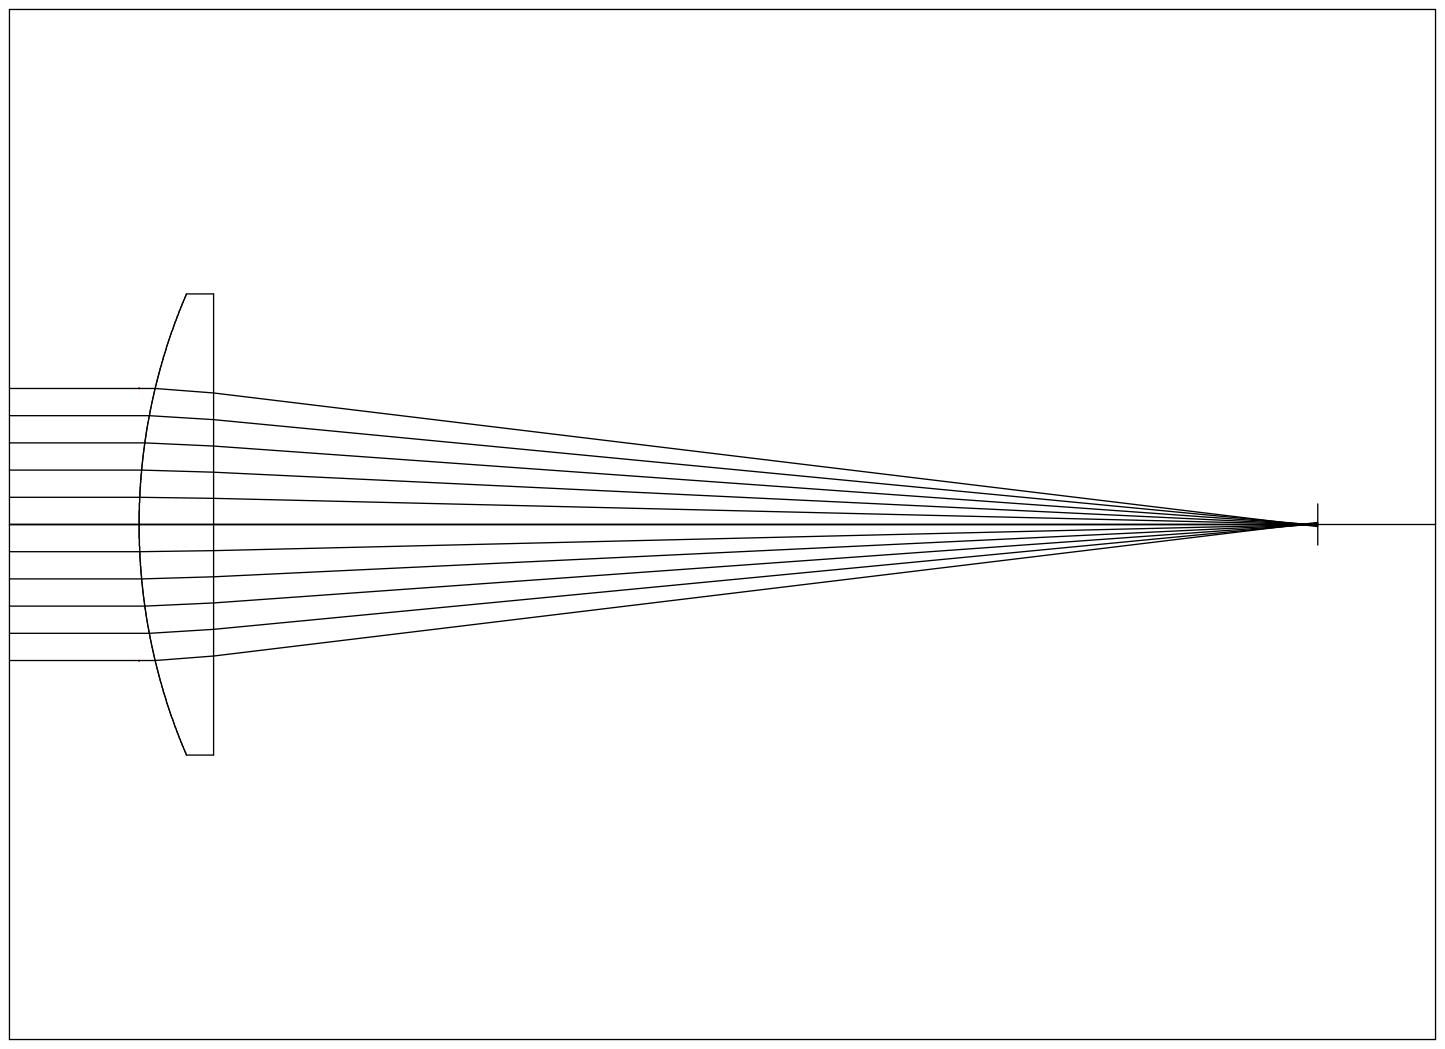
[picture p186: page 1]
