GeeArDee/MScThesis/Thesis/assets/4 experiments/500 and 150 lenses.pdf

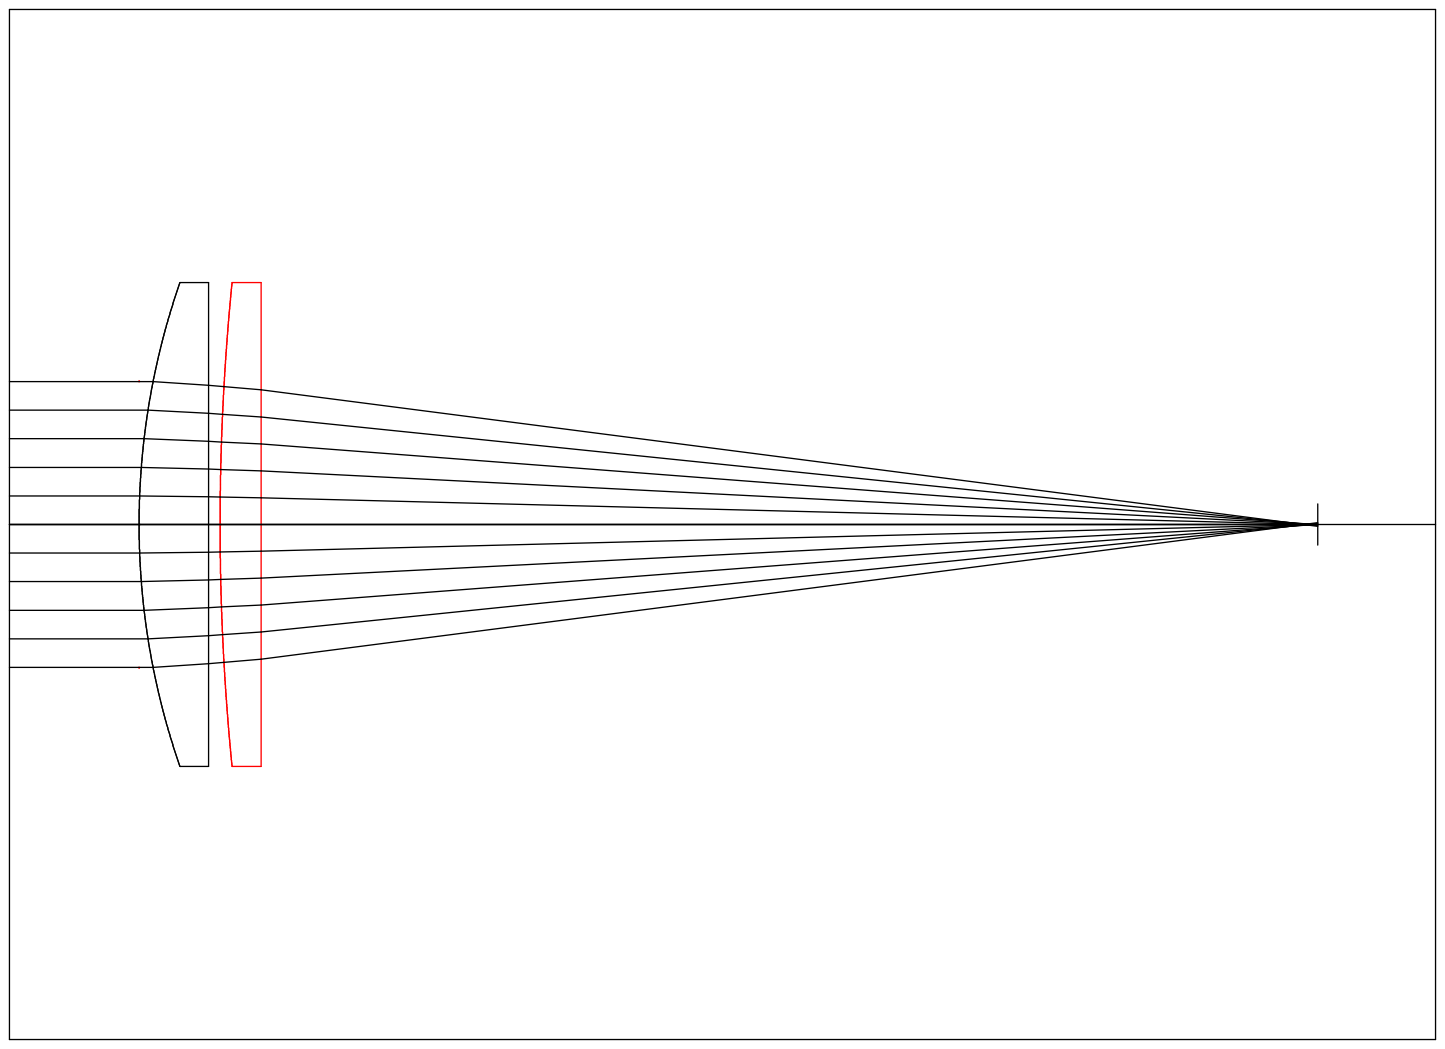
[picture p187: page 1]
