GeeArDee/MScThesis/(commit log)

2024-07-14 switch models and design order
2024-08-04 bubble meter calibration stuff
2024-09-26 Adding files
    [LWM-G_LASERCUT_PROC.dwg]
2024-10-10 Added V1 spark video frames, in process of adding other frames (webcam and V2 stuff)
2024-10-11 Frames of V2 LSP growth, added renders
2024-10-17 NO2 shots pretty and Omega calibration
2024-11-30 stumped on pressure increase and brems difference with Higgins
2024-12-14 Done brems, start plot pressure with time
2024-12-15 got pressure plot
2025-01-13 pressure increase with laser on with time
2025-02-12 0D model at different powers
2025-07-06 Start PDF/A work to print
2025-07-08 printing PDF/A
